openair-collective/openair-cyan/docs/Reference_Docs/extras/Cyan_Q_and_A.md

<h1>CYAN DECARBONIZER Q&A</h1>

<h2>General</h2>

<b>Q1. Where did Cyan come from and who invented it?</b>

A1. The Cyan idea was conceived by Dahl Winters of DeepScience Ltd in late November, 2020. She built and later open-sourced Cyan; it is now the first OSHWA-certified direct air carbon capture unit (https://certification.oshwa.org/us001095.html). 

<b>Q2. What community is contributing to the Cyan project and who can join it?</b>

A2. The OpenAir Collective is the headquarters of the Cyan project. Anyone is welcome to join OpenAir at https://openaircollective.cc/join-us-1 and contribute to the progress of Cyan.

<b>Q3. What is the ultimate goal of the Cyan project? E.g., is it to be an educational resource so people can make their own boxes?</b>

A3. The goal of Cyan is to introduce small-scale carbon removal devices so that people feel more comfortable with the idea of carbon removal and are more likely to support the production and use of larger units. 

<b>Q4. Is there an intention to sell Cyan kits, or maybe completed Cyan units for people that don’t have time to build their own?</b>

A4. We might sell kits and completed boxes in the future, especially if the complexity of these grows, but for now the intention is to have people build their own.

<b>Q5. Is there a goal of OpenAir that open-source businesses might arise using the Cyan (or Violet) technology?</b>

A5. OpenAir wants to promote the growth of carbon removal and direct air carbon capture, so to the extent that open-source businesses might arise, that would seem consistent with our goals. However, there is no current goal to commercialize the Cyan/Violet technology, we just want to get the technology out there for as many people to use and improve.

<h2>Technical</h2>

<b>Q6. What is the mechanism by which humidifying the air improves performance? Is it that the CO2 forms a carbonic acid mist, which reacts with the Ca(OH)2? Or another mechanism?</b>

A6. The mechanism is that there must be a thin layer of water on the surface of each grain of Ca(OH)2 for the CO2 to react with and form carbonic acid. The carbonic acid (H2CO3) can then react with Ca(OH)2 to form CaCO3 and H2O. This is an acid-base reaction and also a double displacement reaction. Humidifying the air increases the opportunity for this thin layer of water to form.

<b>Q7. Would moistening the Ca(OH)2 accomplish the same thing without having to humidify the air?</b>

A7. Moistening the Ca(OH)2 would certainly help the thin layer of water to form faster, but too much moisture impedes the airflow of CO2 between grains of Ca(OH)2. If all the pores are blocked with water, then we have the equivalent of an aqueous solution and CO2 is less soluble in water than in air.

<b>Q8. Are there any studies (theoretical or experimental) of the ideal humidity level?</b>

A8. There have been experimental studies of the ideal humidity level from concrete carbonation. Concrete contains calcium hydroxide and the ideal humidity has been between 50-75% (https://www.sciencedirect.com/science/article/pii/S1110016819301115). 

<b>Q9. What is the purpose in bubbling the air through the water in the bottom of the Cyan? If the air were humidified another way, would there still be any reason to bubble it? And in that case, would the water in the bottom of the box still be needed?</b>

A9. The air bubbling through water serves two purposes - to continuously add CO2 to the system for removal, and to get water onto the filter paper at a slow enough rate that the water is wicked across the filter paper and Ca(OH)2 powder to help form the necessary thin layer of water across each Ca(OH)2 grain. If the air were humidified another way, some mechanism would still be necessary to quickly wet the powder since air humidification is not fast enough (it takes concrete years for its calcium hydroxide to carbonate). The water at the bottom of the box is only there to wet the filter paper through bubbling.

<b>Q10. I saw a reference to an experiment using an ultrasonic humidifier; was that successful?</b>

A10. The ultrasonic humidifier was successful but it was not as energy efficient and required a longer time to thoroughly wet the material to near saturation. With larger quantities of material it might be useful, but for just 10 grams of Ca(OH)2 the emissions due to a power consumption of 24 W (24 V at 1 A) was more than the amount of carbon dioxide that would be removed.

<b>Q11. In the standard Cyan build, is there any significance to the dimensions of the specific hummus container used? Or to the exact depth of the water?</b>

A11. There is no significance to the dimensions of the hummus container used or to the exact depth of the water. The hummus container merely provides something for the filter paper containing the input material to rest on while it is being slowly wetted from below from the air bubbling and consequently the water being disturbed. If it is possible to wet the filter paper through a different means, as through an atomizer, there quite possibly would be no need for standing water at the bottom.

<b>Q12. Can the hummus container be replaced with anything (e.g. a wire shelf) that holds the Ca(OH)2 above the surface of the water?</b>

A12. Yes.

<b>Q13. What is the purpose of using a coffee filter instead of just scattering the material on the upturned lid?</b>

A13. The coffee filter is something that can be weighed beforehand and that also wicks water to slowly wet the Ca(OH)2 powder. Scattering the material on the upturned lid would not allow for easy removal (the powder sticks to the lid) and there is no easy way to slowly wet the powder.

<b>Q14. You mentioned that the aquarium pump can be shut off when the air is humid enough. In that case, how does more air get into the container?</b>

A14. The aquarium pump does not have to be run continuously; it can be shut off for intervals of time while the CO2 already in the container is taken up by the Ca(OH)2. The container is not air-tight so CO2 is always diffusing in and out. 

<b>Q15. Is the drying action of the fans an essential part of the carbon capture process, or is it a temporary R&D addition to the design to allow us to measure the effectiveness by weighing?</b>

A15. A significant amount of CO2 (as much as 50%) is taken up during the drying process and that CO2 uptake is aided by greater airflow. It improves the likelihood that a CO2 molecule will react with the wet Ca(OH)2. However, the fan is not deemed absolutely essential to the carbon capture process. CO2 will still be taken up, just at a slower rate.

<b>Q16. The current design captures about 2g of CO2 for each 10g of Ca(OH)2. How does this compare to the theoretical (stoichiometric) maximum amount that can be captured?</b>

A16. The theoretical maximum amount that can be captured is 5.94 g CO2/10 g Ca(OH)2 (and for Mg(OH)2, it is 7.55 g CO2/10 g Mg(OH)2). We are at best achieving about a third of the theoretical maximum. 

<b>Q17. If current performance is short of the theoretical, is that just because not enough surface area of the powder is exposed to the air?</b>

A17. There are a number of factors involved. Increases in temperature and pressure generally improve reaction rates. However, performance was increased by a factor of two just by manually disturbing the surface of the powder once, halfway during the experimental run. This leads us to believe that there is a surface area limitation. Mechanically disturbing the layer of powder in an intermittent manner should help greatly.

<b>Q18. Would efficiency be expected to improve if the air is made turbulent?</b>

A18. We believe we are not seeing laminar airflow in our system given the fluid properties and speeds of the air. The air is likely already turbulent, and especially so when the fan is being used for drying. If the air is made even more turbulent, efficiency could possibly improve, but this has not been tested.

<b>Q19. Has there been any confirmation of the accuracy of the weighing method for measuring captured CO2?</b>

A19. The weighing method is called gravimetric analysis and is widely used in chemistry for measuring the amount of a compound based on its mass. It suffers from the ability of product to be lost through container transfers and through evaporation. Of higher accuracy would be thermogravimetric analysis, but this is expensive and time consuming.

<b>Q20. What other materials besides Ca(OH)2 have been tried, and with what success?</b>

A20. Mg(OH)2 has been tried with similar and possibly slightly higher levels of carbon removal. It is also a more friendly material in terms of pH.

<b>Q21. Has anyone tried to calculate the carbon footprint of the whole device (plastic, etc.)?</b>

A21. Not completely, but it has been partially attempted. The carbon footprint of the energy consumption and the transportation of input material has been taken into account in the Cyan Supporting System Calculations.xlsx document available from our GitHub repository. In a separate document, estimates of the energy consumption used in producing Mg(OH)2 have also been done, namely to determine the degree of impact of various manufacturing processes on Cyan’s ability to achieve negative emissions. 

<b>Q22. Would it work to dissolve the X (OH) in solution, bubble the air through it, and let the X (CO3) precipitate out?</b>

A22. This would indeed work; aqueous solutions are used in industrial carbon removal (Carbon Engineering for example uses an aqueous solution of KOH). The difficulty here is in controlling leakage and evaporation effects and in filtering out the precipitate to weigh it and calculate the amount of CO2 captured. Inevitably, some precipitate sticks to the inner walls of the device, causing product losses prior to weighing.
