openair-collective/openair-cyan/docs/Reference_Docs/Aqueous-Cyan/Presentations/Aqueous CYAN Update  9-13-2021.pdf

# Aqueous CYAN Update

David Wilson
dw@ieee.org September 13, 2021

Topics:

•New pH probe!
•Aqueous run with pH and EC •Scaling up?

## Aqueous CYAN Basics

- Same reaction as Classic CYAN: Ca(OH)2 + CO2 → CaCO3 + H2O
- Parts reuse: Aquarium pump, air stone, chemicals, soda bottle
- Newer: Electrical Conductivity (EC) Monitoring
- Even newer: pH meter

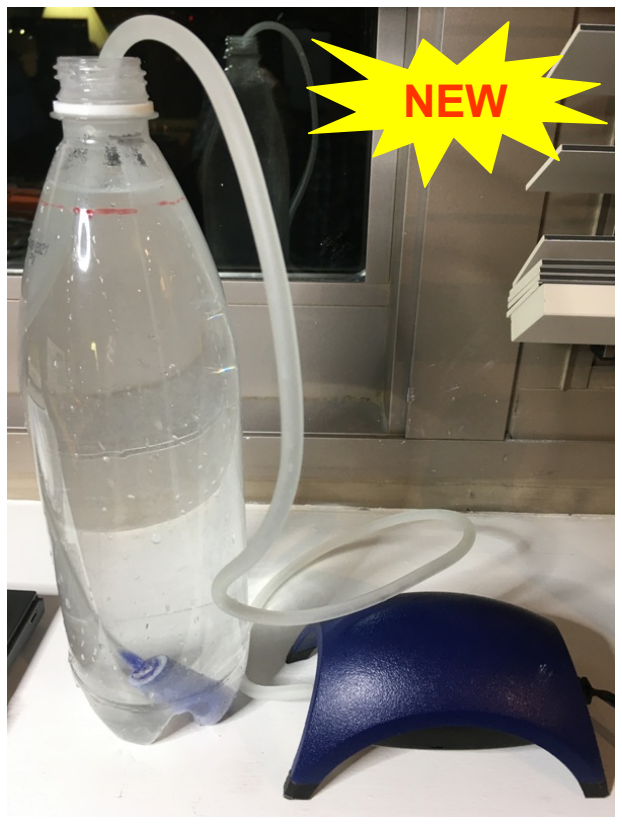
[picture p6: figure]
NEW

## EC Measurement

https://hackaday.io/project/7008-fly-wars-a-hackers-solution-to-world-hunger/log/24646-three-dollar-ec-ppm-meter-arduino

•Probe: 2 wires, 2 buttons
•Circuit: voltage divider and uC
•PULSED measurement required •OMIT temperature adjustment •Note: EC probe interferes with pH measurement, so had to isolate (not shown)

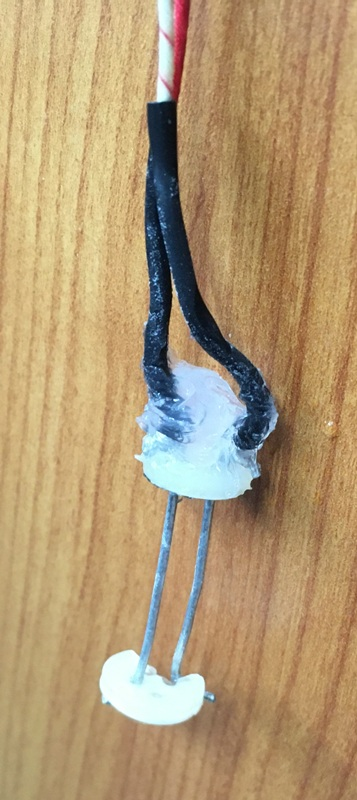
[picture p7: figure]
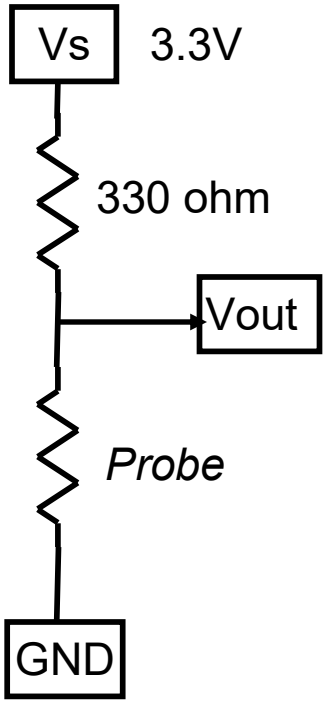
[picture p8: figure]
GND; Vout; 330 ohm; Probe

## Han’s Paper

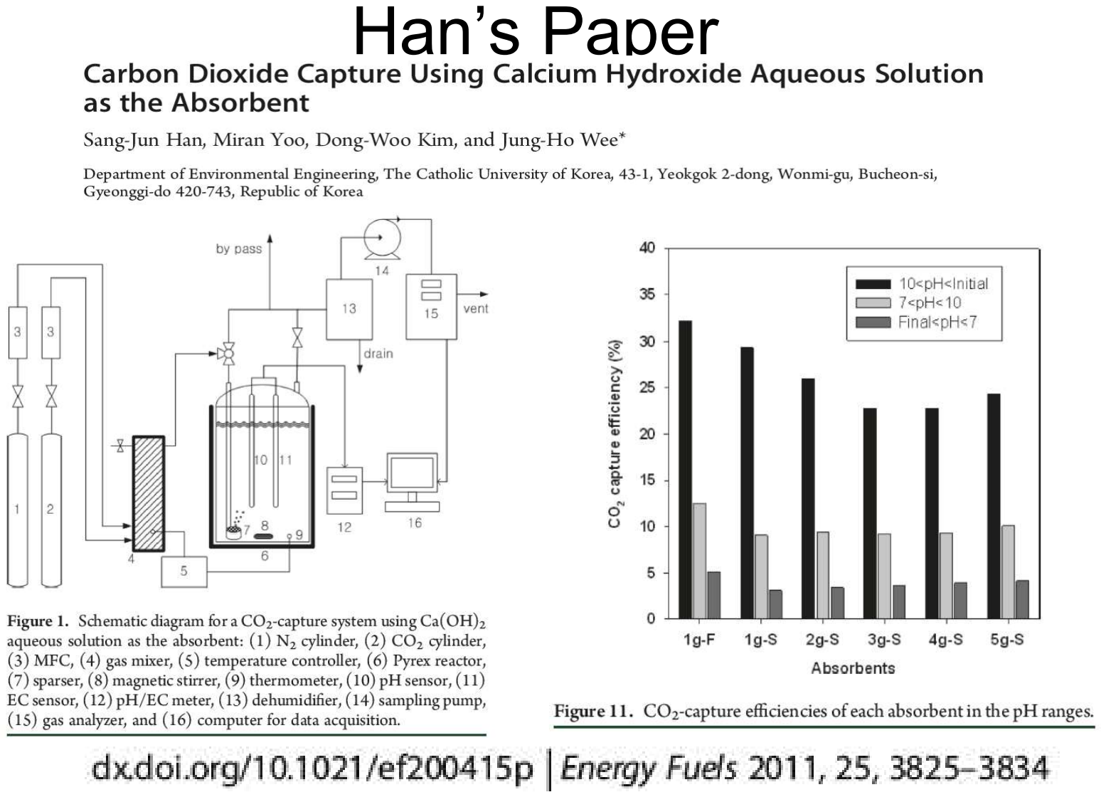
[picture p9: page 4]

## Han Paper Detail

Saturated Ca(OH)2 solution

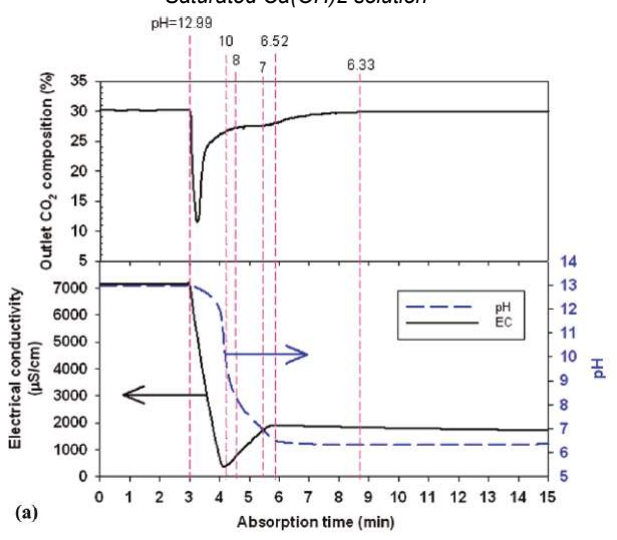
[picture p10: figure]

## Newest Experiment: Now with pH Meter

- 1g Ca(OH)2

in 1L water. Solubility of Ca(OH)2 in H2O:

### 1.73 g/L at 20C. [Same as last time]

- Calibration of EC probe: estimate 8000uS/cm (*) in our solution
- Pumped air through air stone (bubbler), while measuring EC every 30 seconds.
- Also measured pH (with meter).
- Kept going until EC and pH flattened out
- Used distilled water this time: no initial sediment

•Note on units: S ≡ Siemens ≡ mho ≡ 1/ohm
•It is /cm because it’s a spatially distributed resitance

# Results (1g/L)

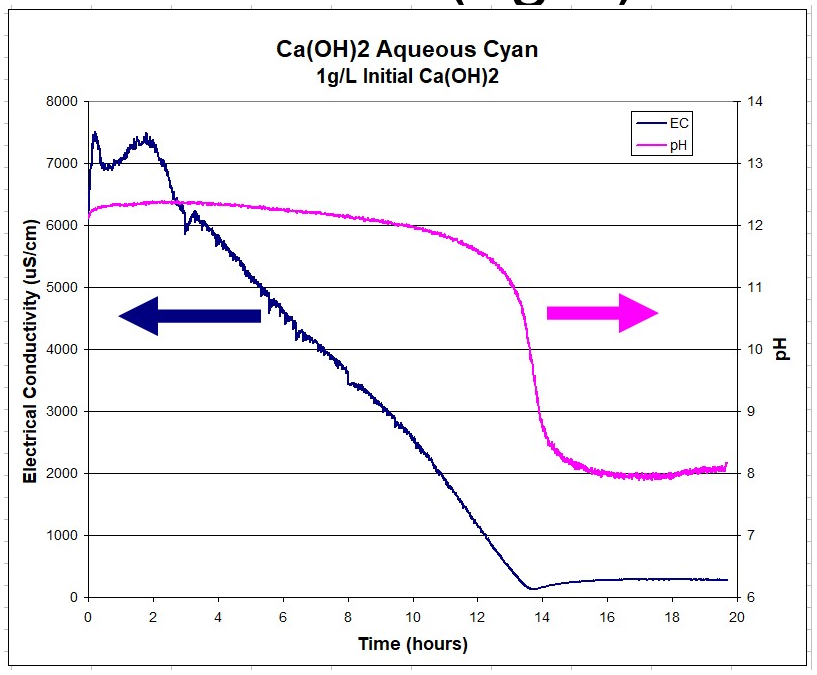
[picture p11: figure]

## What if we take log10 of EC?

(and shift to line up with pH)

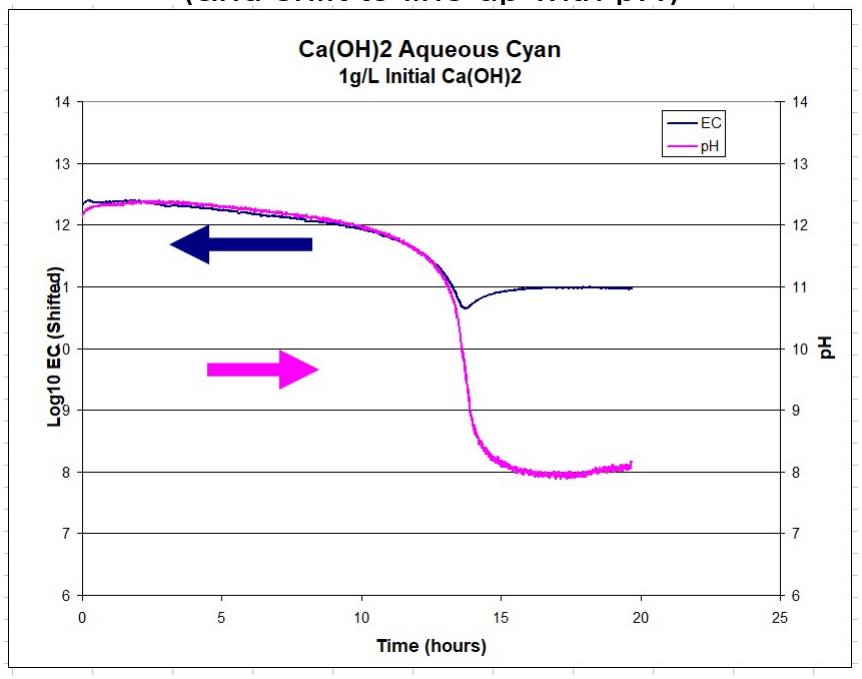
[picture p12: figure]

# Scaling up: 10g/L Aqueous Test

First run, uninterrupted

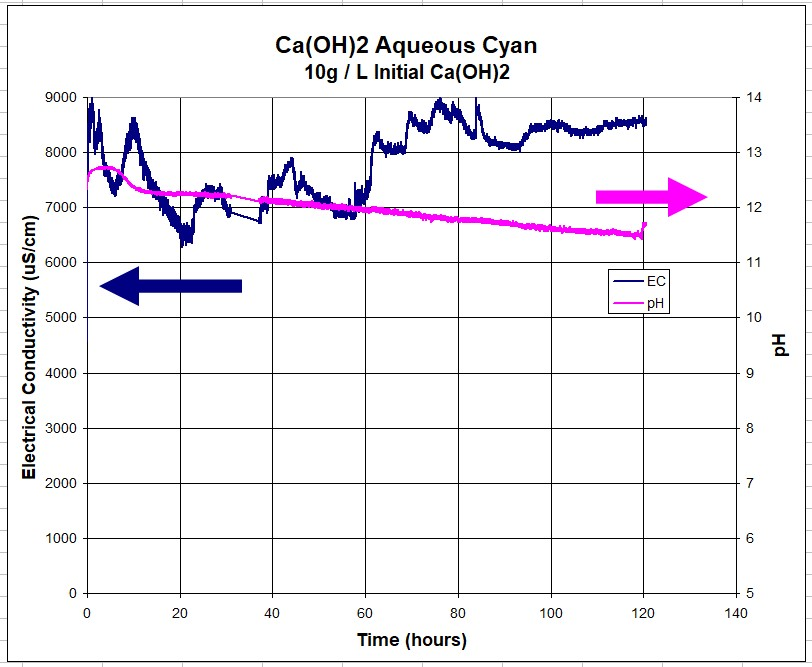
[picture p13: figure]

# Why?

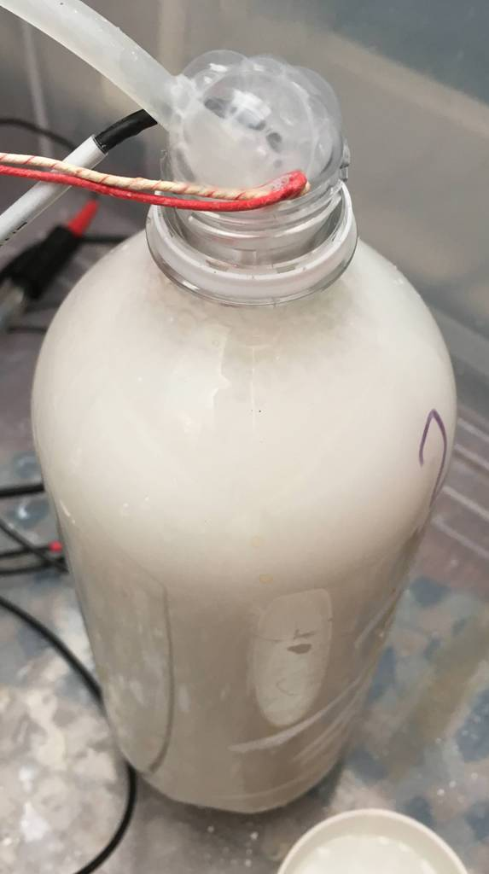
[picture p14: figure]

- Air stone getting clogged before run finishes
- Air stone not resting on bottom, so sediment+input
material not getting stirred up

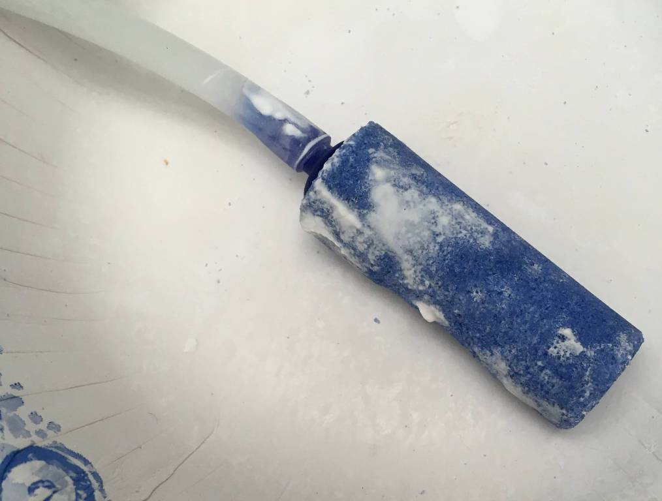
[picture p15: figure]

## Continuing Issue: Dirty Air Stone

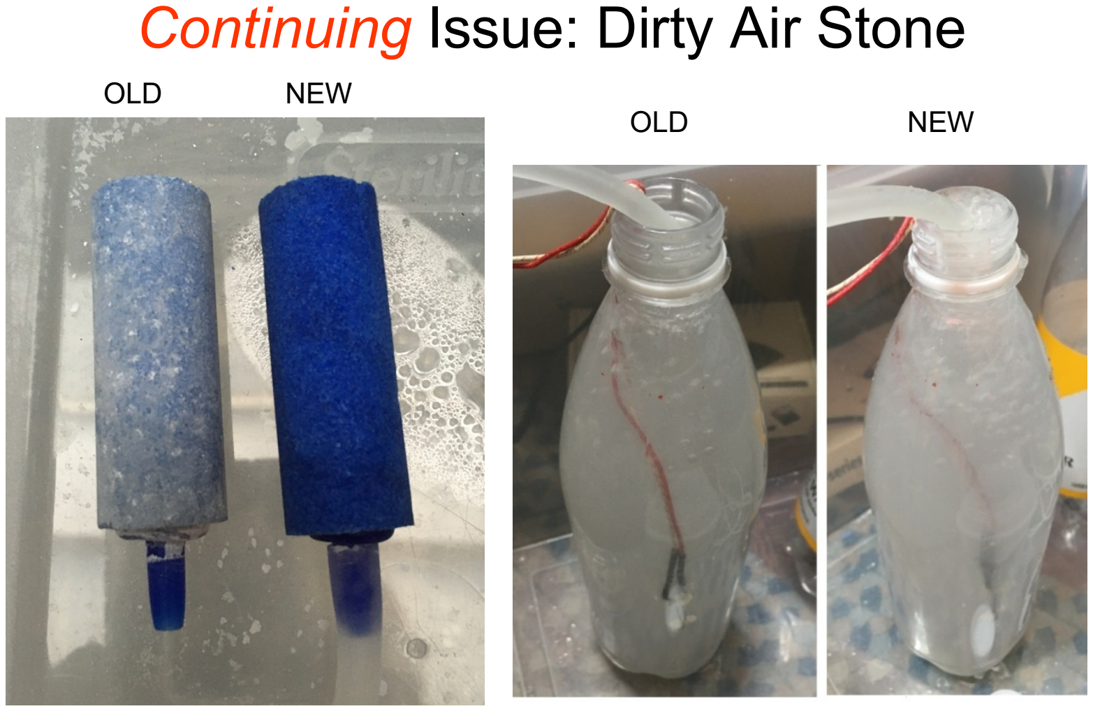
[picture p16: page 11]

OLD
OLD

NEW
NEW

# Attempted remedies

## - Clean air stone - Shake bottle thoroughly to stir up sediment - Make sure air stone rests on bottom of bottle to stir up sediment

## Scaling up: 10g/L Aqueous Test

CONTINUED after remedies

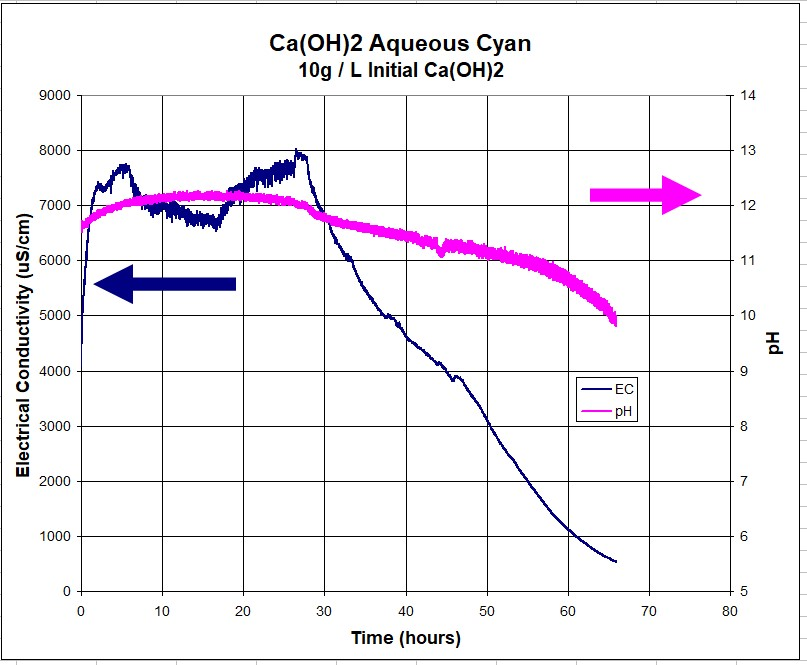
[picture p17: figure]

# After 10g run…

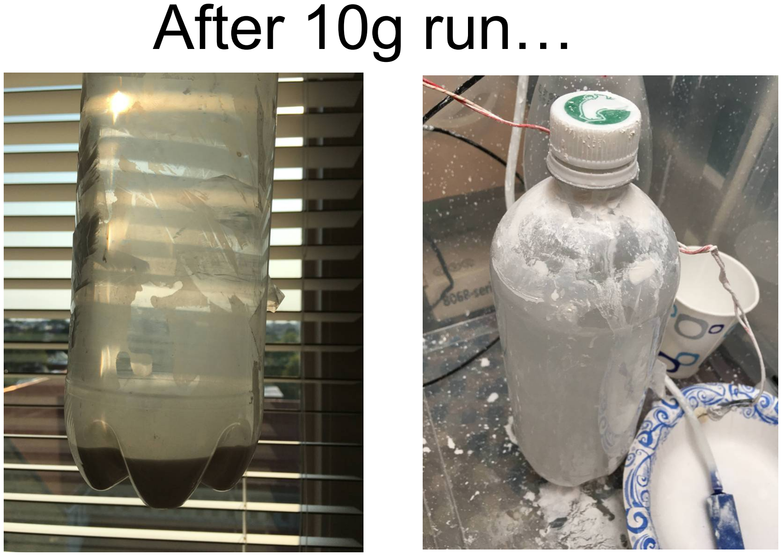
[picture p18: page 14]

## - Better aerator (sparger) needed? - Understand pH vs. EC - Need to pump more air - How to separate and dry precipitate? - Weigh precipitates from both runs and calculate amount of CO2 captured

# For Followup
