openair-collective/openair-cyan/docs/Reference_Docs/Aqueous-Cyan/Presentations/Aqueous CYAN Update  7-26-21.pdf

# Aqueous CYAN Update

David Wilson
dw@ieee.org July 26, 2021

## Aqueous CYAN Basics

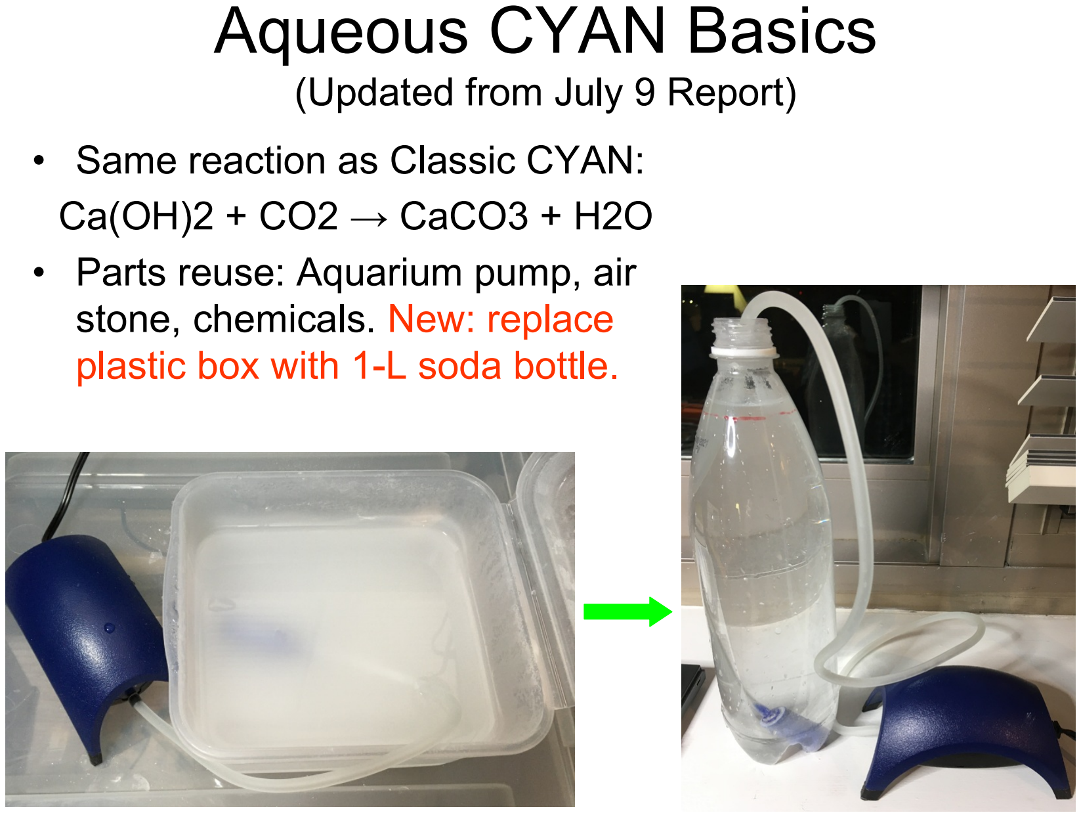
[picture p27: page 2]

(Updated from July 9 Report)
- Same reaction as Classic CYAN: Ca(OH)2 + CO2 → CaCO3 + H2O
- Parts reuse: Aquarium pump, air stone, chemicals. New: replace plastic box with 1-L soda bottle.

## Han’s Paper


## Main Take-aways (for me) from Han’s Paper

- When pH goes < 10 as CO2

is captured, CaCO3
(precipitate) production STOPS.
- As pH continues to drop, CaCO3 combines with more CO2

to produce (soluble!) HCO3

ions…
- …until by the time pH <7, there’s no more CaCO3 precipitate.
- We should stop when pH reaches 10, so we can recover solid output, and
- Most CO2 has already been captured.

## Han Paper Detail

Saturated Ca(OH)2 solution


# My Experiment

## - 1g Ca(OH)2

in 1L water. Solubility of Ca(OH)2 in
H2O: 1.73 g/L at 20C.
- Pumped air through air stone (bubbler), periodically checking pH with pH paper.
- Stopped when pH reached 10.

# pH vs. Time

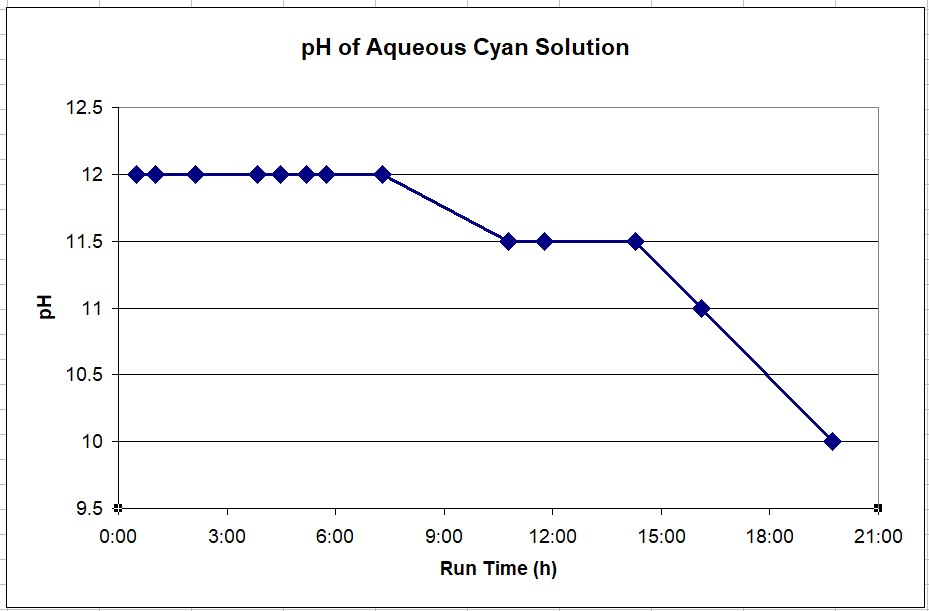
[picture p28: figure]

# Results

- Stopped at 19:44.

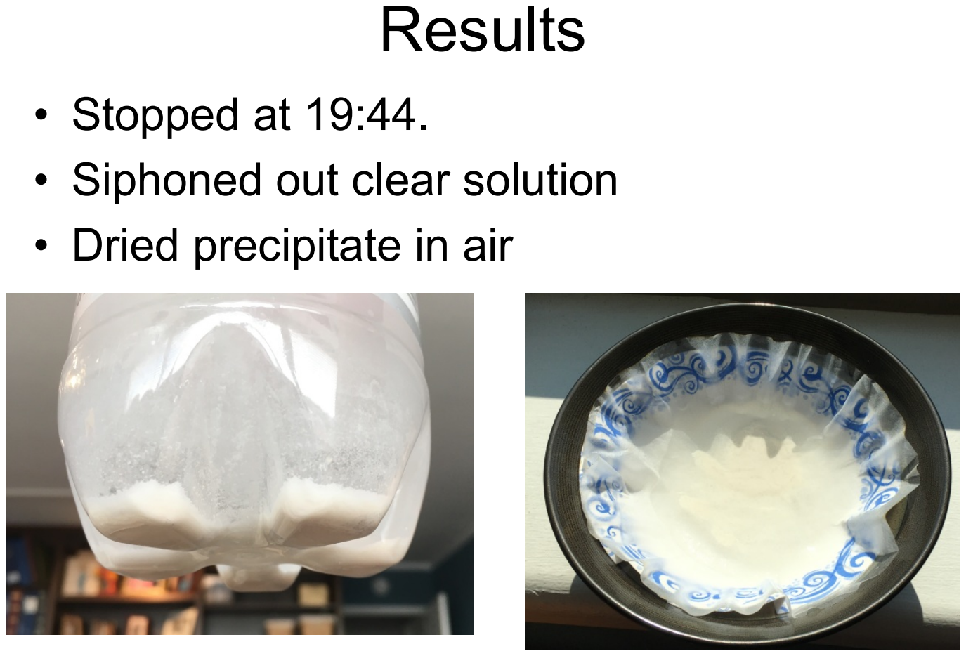
[picture p29: page 8]

## - Siphoned out clear solution - Dried precipitate in air

# Analysis

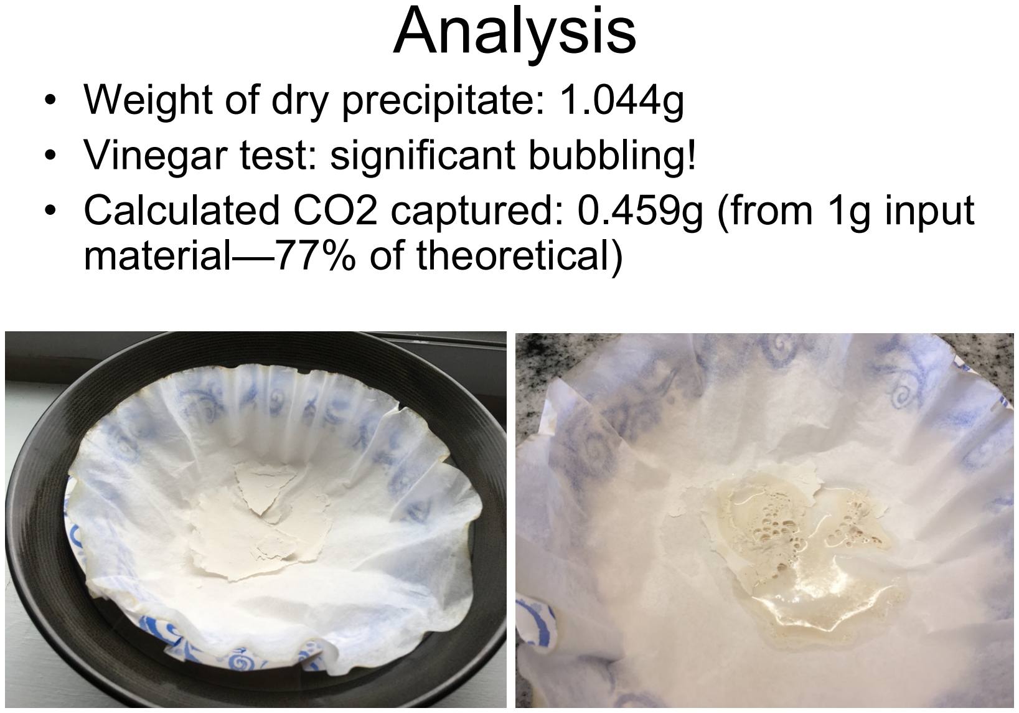
[picture p30: page 9]

- Weight of dry precipitate: 1.044g
- Vinegar test: significant bubbling!
- Calculated CO2 captured: 0.459g (from 1g input material—77% of theoretical)

## - Caveat: calculated capture amount may be over-estimate due to impurities in water

and sorbent.

## - Ideas for automating end of process:

– Electronic pH meter ($$)
– Electronic resistivity measurement ($)

## - Need to pump more air - How to separate and dry precipitate?

# Followup
