openair-collective/openair-cyan/docs/Reference_Docs/Aqueous-Cyan/Presentations/Aqueous CYAN Update  8-2-2021.pdf

# Aqueous CYAN Update

## David Wilson dw@ieee.org August 2, 2021

Topics:

•Dirty Air Stone
•Homemade EC probe
•Another Cyan run using EC probe

# Aqueous CYAN Basics

## (Updated from July 9 Report)

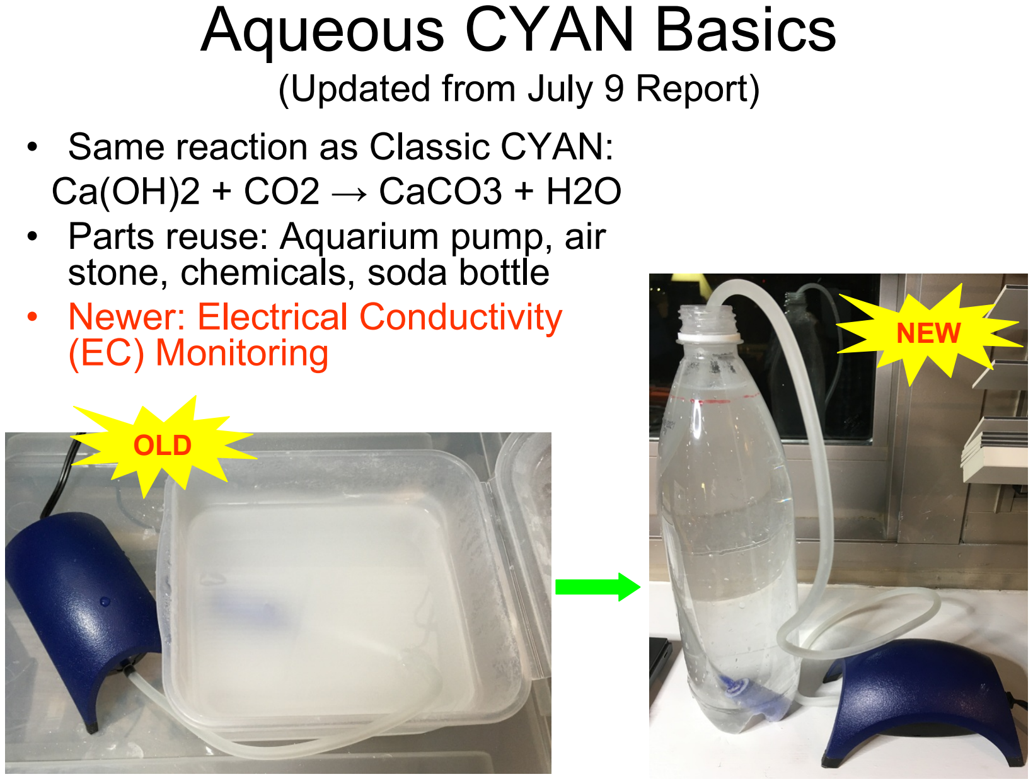
[picture p31: page 2]

## - Same reaction as Classic CYAN: Ca(OH)2 + CO2 → CaCO3 + H2O - Parts reuse: Aquarium pump, air stone, chemicals, soda bottle - Newer: Electrical Conductivity (EC) Monitoring

OLD

NEW

# New Issue: Dirty Air Stone

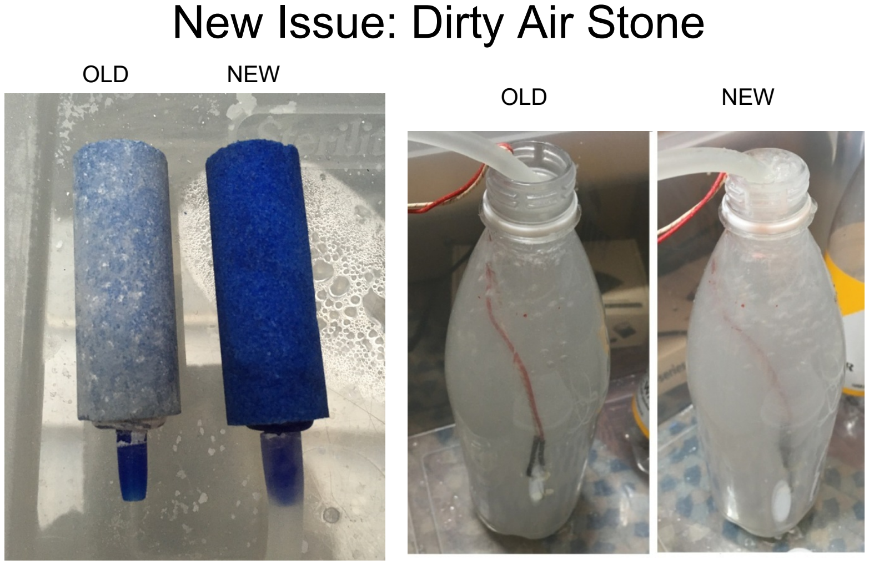
[picture p32: page 3]

OLD
OLD

NEW
NEW

# EC Measurement

https://hackaday.io/project/7008-fly-wars-a-hackers-solution-to-world-hunger/log/24646-three-dollarec-ppm-meter-arduino

GND; Vout; 330 ohm; Probe

•Probe: 2 wires, 2 buttons
•Circuit: voltage divider and uC
•PULSED measurement required •OMIT temperature adjustment

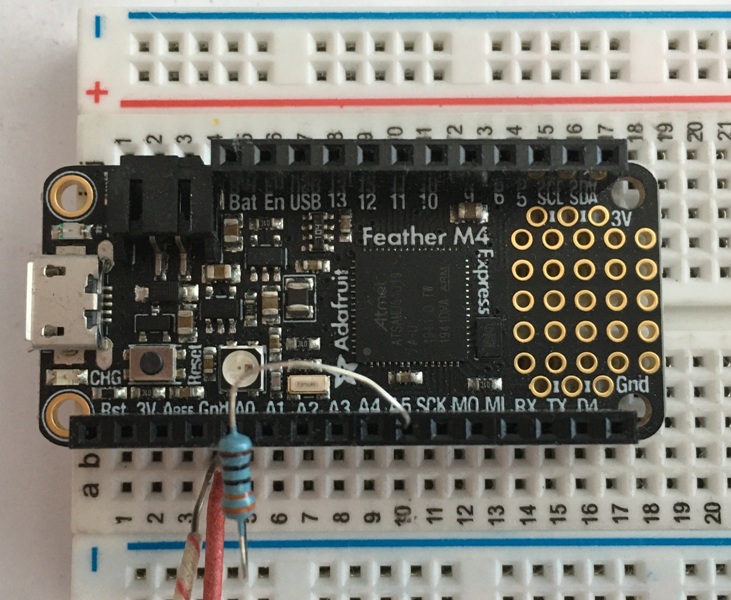
[picture p33: figure]

# Han’s Paper


# Han Paper Detail


Saturated Ca(OH)2 solution

# Newest Experiment

## - 1g Ca(OH)2

in 1L water. Solubility of Ca(OH)2 in H2O:

### 1.73 g/L at 20C. [Same as last week]

## - Calibration of EC probe: estimate 8000uS/cm (*) in our solution - Pumped air through air stone (bubbler), while

measuring EC every 30 seconds.
- Periodically measured pH (with paper).

## - Kept going until EC and pH flattened out

•Note on units: S ≡ Siemens ≡ mho ≡ 1/ohm
•It is /cm because it’s a spatially distributed resitance

# Results

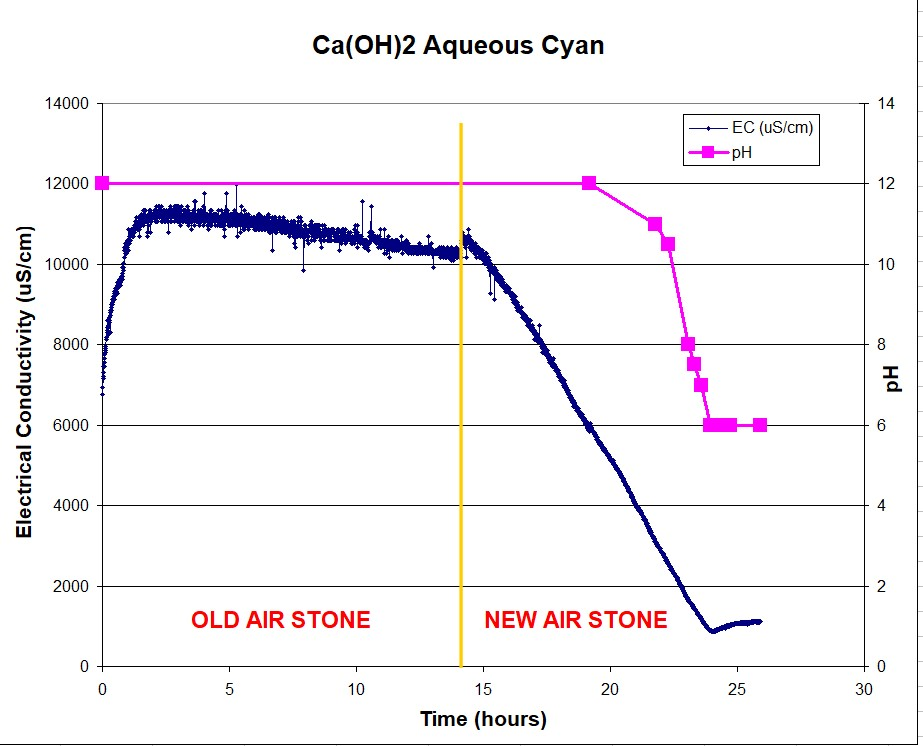
[picture p34: figure]

- Understand overshoot in EC at start.

# - Better air stone (sparger) needed? Or

keep, but clean or dispose.

# - Ideas for automating end of process:

## – Electronic pH meter ($$) – Electronic resistivity measurement ($)

# - Need to pump more air - Distilled water? Purer sorbent? - How to separate and dry precipitate?

# For Followup
