openair-collective/openair-cyan/repo-tools/CODE_OWNERS.md

# Code Owners

In addition to @dahlwinters the following code is mainly owned by:

| Code | Owner
|---|---
| CO2 Measurement |
| all | @DavidWilsonEE
| |
| Platformio Source Code |
| all | @ZanzyTHEbar
| |
| Documentation Webpage | @ZanzyTHEbar
