openair-collective/openair-cyan/docs/assets/images/vtEUvj4.jpeg

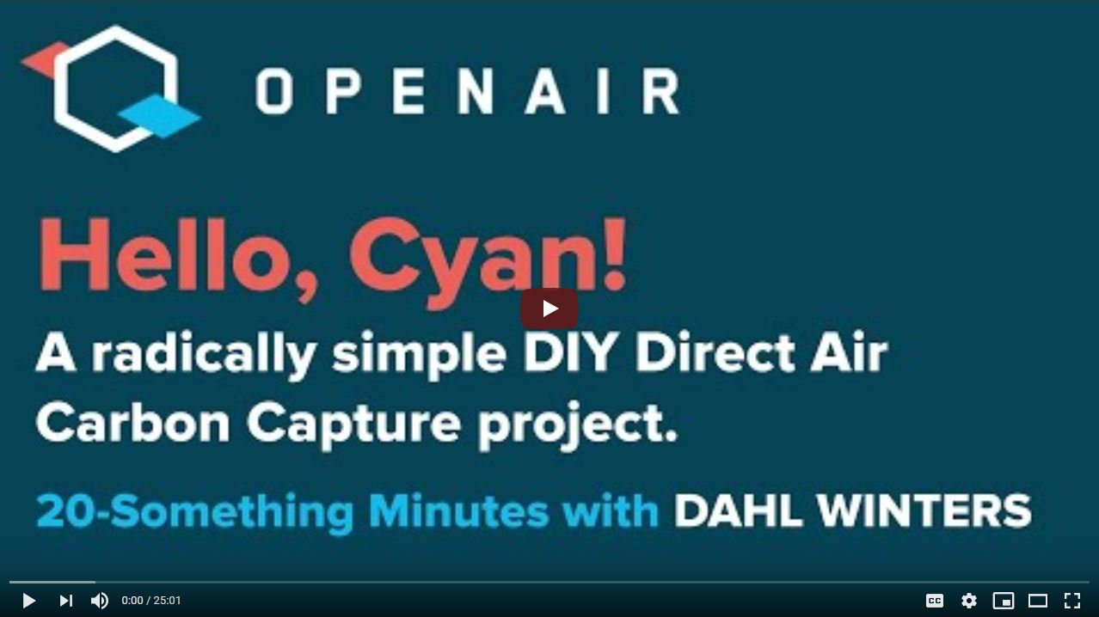
docs/assets/images/vtEUvj4.jpeg
