openair-collective/openair-cyan/docs/assets/images/assemblyinst/humidified_material.png

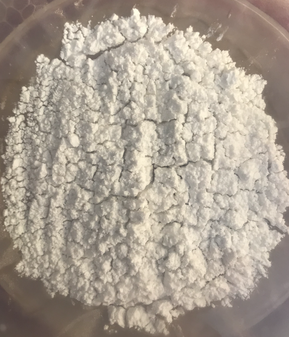
docs/assets/images/assemblyinst/humidified_material.png
