openair-collective/openair-cyan/docs/assets/images/assemblyinst/wet_filter_and_material.png

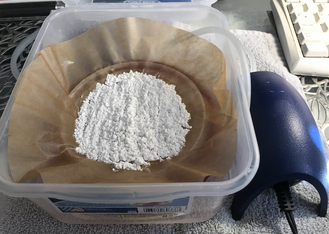
docs/assets/images/assemblyinst/wet_filter_and_material.png
