openair-collective/openair-cyan/Cyan_Assembly_Instructions.pdf

## Cyan: Open-Source Micro Direct Air Carbon Capture

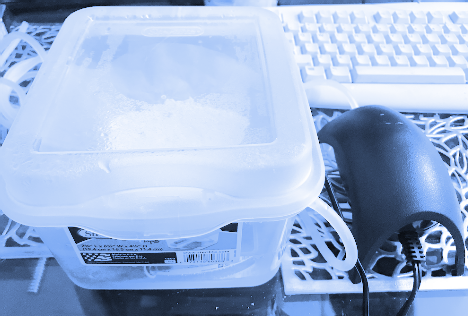
[picture p38: figure]

# Assembly Instructions

Dahl Winters, Member, OpenAir Collective

Purpose: These are instructions to build a DIY DACC unit for home or classroom use.

Expected results: an up to 12.5% weight increase from CO2 uptake over the course of a 16-hour period when starting with 10 g input material. This translates into about a 2.1 g CO2 uptake obtainable during a single run.

Minimal parts cost: <$20. All the bells and whistles mentioned: about $100.

A live version of this document can be found on our Cyan Google Drive at: https://drive.google.com/drive/folders/1jJmSW5A4CJa3AI3WlE5lJOv2GNdNztFd?usp=sharing 1

Table of Contents
Introduction | 3
CHEMISTRY AND BENEFITS | 3
CHALLENGES AND LIMITATIONS | 3
SAFETY CONSIDERATIONS | 4
Parts List | 5
Tools and Skills Needed | 9
Optional Materials for Testing | 9
Assembly Time Required | 9
Construction | 10
HUMIDIFIER BOX | 10
BOX AND FAN: AIRFLOW HANDLING | 12
Operation | 15
CALCULATING CO2 UPTAKE | 15
CONFIRMING THE PRESENCE OF CO2 | 16
STORAGE | 16
DISPOSAL/REUSE | 16
More Pictures | 17

2

Introduction

The goal of this project was to build a high-efficiency, very low cost direct air carbon capture (DACC) system. We call the system Cyan in honor of Violet, OpenAir’s moisture swing sorbent DACC, and also in honor of cyanobacteria, whose combined efforts transformed the early Earth’s atmosphere. Similarly, we believe millions of distributed, consumer-scale DACC units could someday complement large-scale DACC efforts and make a difference when it comes to climate change. This unit will not solve the climate crisis alone, but many of these will open doors to discussion, education, behavior changes, modifications, and further R&D to improve the state of DACC. And that is what we desperately need to limit the possibility of dangerous warming.

Chemistry and Benefits

The carbonation reaction (also known as carbonatation) is being used to capture CO2 as follows:

Ca(OH)2 + CO2

-> CaCO3 + H2O

This reaction takes place naturally, especially in concrete, but typically takes a very long amount of time (months to years). Cyan speeds up the reaction considerably by increasing the relative humidity and forcing this “wet” air into the reaction chamber to offset CO2 declines as the reaction progresses.

Calcium carbonate (CaCO3

) is a safe output that is actually the main constituent of limestone. It can be extracted, filtered, dried, weighed, and the quantity of CO2

taken up can be determined through calculation from the weight. No equipment is required to pressurize the captured CO2

, making
Cyan a good choice for true consumer-scale DACC.

Challenges and Limitations

The carbonation reaction is slow due to the formation of a passivating layer of CaCO3 around Ca(OH)2 molecules. While bubbles of CO2 were produced upon filtering, drying, and applying 5% distilled white vinegar (acid test for the presence of CaCO3

), it is very likely that not all the Ca(OH)2 is converted to CaCO3

in 24 hours. Thus we still need to quantify the amount of CO2

that is
captured per gram of Ca(OH)2

to see how that depends on different variables.

To achieve true negative emissions using Cyan, you will need to start with a source of carbon-neutral Ca(OH)2

. Hydrated lime is a good consumer source; it is very easy to buy hydrated lime at a gardening or hardware store. However, this hydrated lime comes from calcium oxide (lime) produced through calcination, a very energy-intensive process with temperatures above 900 degrees Celsius. This energy is typically supplied mostly by fossil fuels, though renewable sources are becoming increasingly prevalent in the energy mix. There are projects underway to produce 3 lime through concentrated solar, but for now this is a one-way reaction to produce calcium carbonate without regenerating the lime.

Safety Considerations

Ca(OH)2 comes in powdered form and although it has uses in pickling and gardening, it can do great damage if rubbed into the eyes, inhaled, or ingested. Scoop the material and avoid pouring; if you do pour, a mask should be worn so as not to inhale the dust.

Do not ingest any reactant or product, even the calcium carbonate you produce. It’s never a good idea to eat the products of your chemical reactions.

Also, since the aquarium air pump does not have a grounding plug (the case for most such pumps), the safety considerations for working with electricity near water should be observed.

4

Parts List

The following 5 items are the minimum required parts to construct a Cyan. Total cost <$20.

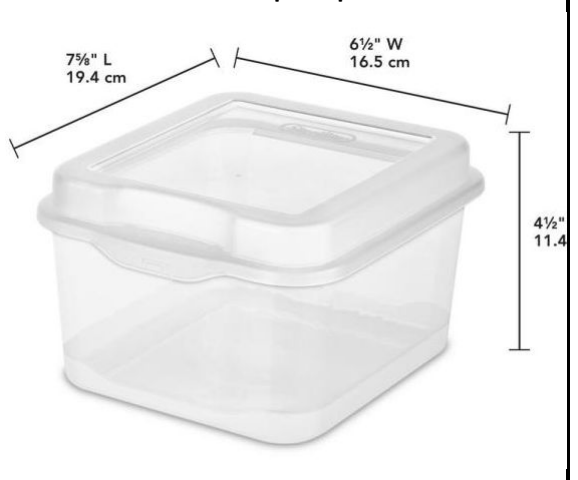
[picture p39: figure]
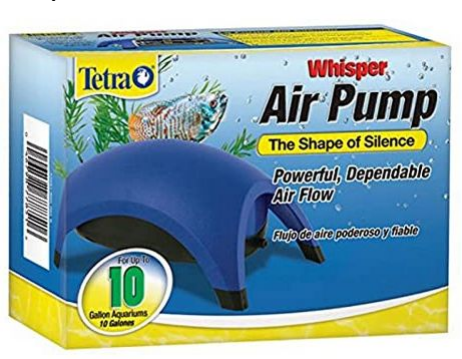
[picture p40: figure]
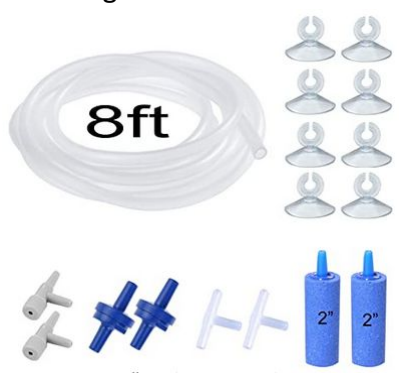
[picture p41: figure]

1
https://www.homedepot.com/p/Sterilite-2-5-Qt-Flip-Top-Box-18038612/203002006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 (https://www.homedepot.com/p/Sterilite-2-5-Qt-Flip-Top-Box-18038612/203002006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)
2 https://www.amazon.com/Tetra-Whisper-Easy-Aquariums-Non-UL/dp/B0009YJ4N6
3 https://www.amazon.com/gp/product/B0797QFV4D
5
Item | Use | Qty | Price | Qty for price

Per unit
price

Units
used

Subtotal

Sterilite 2.5 Qt FlipTop 1 | Outer container (“humidifier box”), dimensions are 7 5/8" x 6 1/2" x 4 1/2" | 1 | $2.28 | 1 | $2.28 | 1 | $2.28
Tetra Whisper 10 Aquarium Air 2 Pump | For airflow to let in CO2 ; needs AC outlet, 1.5 watts only | 1 | $5.06 | 1 | $5.06 | 1 | $5.06
3 Air Tubing and Air Stone | To disperse the air from the air pump, 3/16” diameter | 1 | $4.99 | 2 | $2.50 | 1 | $2.50

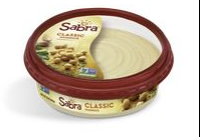
[picture p42: figure]
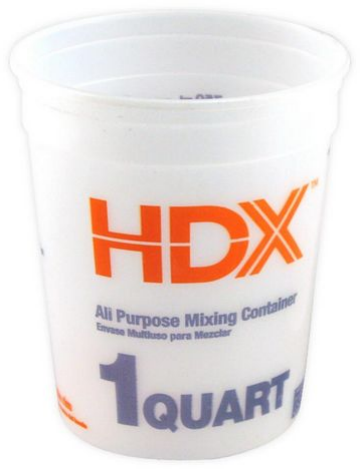
[picture p43: figure]

4 https://www.walmart.com/ip/Sabra-Roasted-Red-Pepper-Hummus-10-oz/10850131 5 https://www.homedepot.com/p/HDX-1-qt-Multi-Mix-Pail-2M3/202264024
6
Empty Sabra Hummus Container, 4 10 oz | Used for spacing; coffee filter goes on the HDX Quart lid that floats on top of this container. Could potentially remove or size down to add more space for Ca(OH)2 . | 1 | $3.34 | 1 | $3.34 | 1 | $3.34
Lid from HDX Quart Container 5 | Has a lid that the coffee filter holding the Ca(OH)2 sits in so as not to get too wet. Also comes graduated with lines, useful for measuring and mixing materials. | 1 | $1.38 | 1 | $1.38 | 1 | $1.38
total | $17.05

Below are optional items - you may choose to put the above setup within the file box below for easy portability and to expand the amount of space available for carbon capture. Mounting the fan on the box will also allow you to dry your CaCO3

faster once you are done humidifying it, though the fan also uses about 3 more watts of electricity. The fan may contribute to extra CO2 uptake during the drying time.

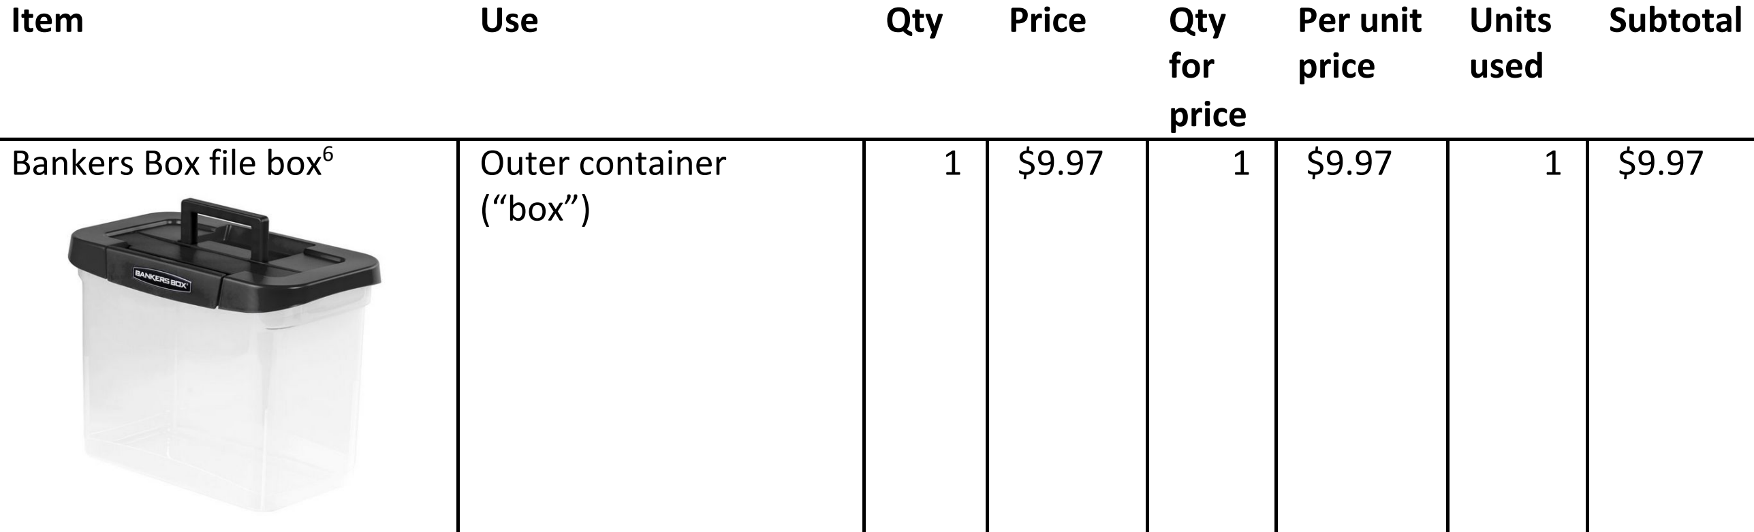
[picture p44: figure]
Item; Use; Qty; Price; for price; Per unit price; Units used; Subtotal; Bankers Box file box 6; Outer container (“box”)

6 https://www.walmart.com/ip/Bankers-Box-Plastic-Portable-File-Box/155376229
7 https://www.amazon.com/gp/product/B00G05A2MU/ref=ppx_yo_dt_b_asin_title_o02_s02?ie=UTF8&psc=1 8 https://www.amazon.com/dp/B08FY7QQ6L?psc=1&ref=ppx_pop_dt_b_product_details
9 https://www.amazon.com/gp/product/B08CC6SYCH/ref=ppx_yo_dt_b_asin_title_o02_s02?ie=UTF8&psc=1
7
120 mm computer fan, AC Infinity Multifan S3 7 | Airflow, USB-powered, 3 speeds | 1 | $11.99 | 1 | $11.99 | 1 | $11.99
120 mm safety grilles 8 | Comes in packs of 4 for screening air | 3 | $6.99 | 4 | $1.75 | 3 | $5.24
USB and AC power adapter 9 | for everything to plug into | 1 | $14.99 | 1 | $14.99 | 1 | $14.99
total | $43.94

If you don’t already have a scale to weigh your Ca(OH)2

, this is a good one, along with a source of Ca(OH)2

to get you started and some coffee filters for holding your samples:

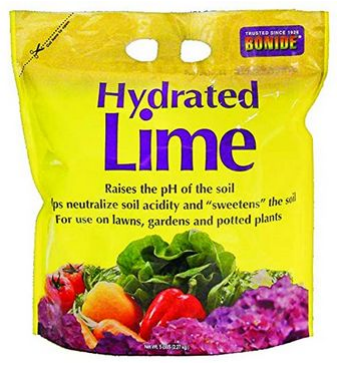
[picture p45: figure]
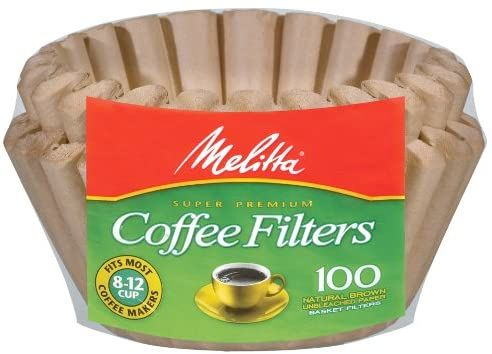
[picture p46: figure]

10 https://www.amazon.com/Triton-Digital-Pocket-Formula-Jewelry/dp/B00AE0GVYK
11 https://www.amazon.com/Bonide-Chemical-Number-5-Hydrated-Lime/dp/B00BSH0U4A 12 https://www.amazon.com/Melitta-Basket-Filters-Natural-Unbleached/dp/B00027930Y
8
Item | Use | Qty | Price | Qty for price

Per unit
price

Units
used

Subtotal

Triton T2 scale 10 | Weighing Ca(OH)2 | 1 | $18.95 | 1 | $18.95 | 1 | $18.95
Bonide Hydrated Lime, 5 11 lb | Main input; for capturing CO2 . Can also try hydrated lime from a hardware store in the cement aisle; there they have 50 lb bags for the same price as this 5 lb bag. . | 1 | $17.02 | 1 | $17.02 | 1 | $17.02
12 Coffee filters, 8-12 cup | Holding the Ca(OH)2 -you can weigh the filter beforehand, write the weight on the filter, then add your Ca(OH)2 , run, dry, weigh, then subtract the filter weight to get your product weight. | 1 | $7.99 | 100 | $0.08 | 100 | $7.99
total | $43.96

Tools and Skills Needed

- Drill with 8/32” drill bit (for fan mounting holes)
- Scissors (useful for cutting tubing)
- Box cutter (for scoring and cutting the fan ventilation holes)
- Sharpie or other permanent marker (optional but very useful)
- Small reciprocating saw (optional - would be useful for cutting the round ventilation holes on the sides of the file box)

Optional Materials for Testing

- 5% distilled white vinegar (for testing for CaCO3

)

- Spoon (for dispensing Ca(OH)2 without the need to pour it)

Assembly Time Required

Minimal unit assembly takes a few minutes, assuming you’ve already eaten the hummus from the hummus container. The file box + fan assembly can be done in 2 hours following the provided instructions.

9

Construction

Humidifier Box

Wash the Sabra hummus container (“container”) thoroughly. Create a hole in the center of the lid since you will be letting in water, otherwise the container will float within the box. You may wish to remove a few labels before placing the lid on top and placing the whole assembly within the Sterilite FlipTop box.

Cut about 1 foot of air tubing (this may be too
short for your needs, but ideal if you are locating
the pump directly alongside the box). Attach the tubing to the pump, then attach the air stone to the other end of the tubing. The air stone is the blue porous ceramic object; air blows into the stone and finely diffuses through to create many small bubbles.

Place the container inside the box. It should fit very nicely and effectively divide the space
between the upper and lower halves of the box.

Fill the box up to the level of the container lid

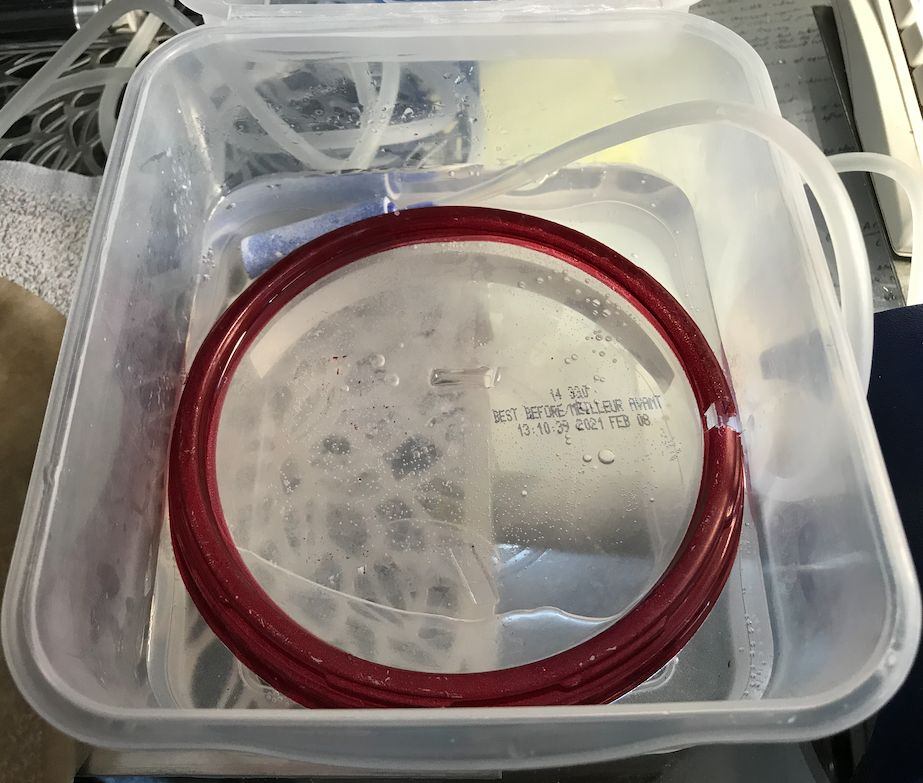
[picture p47: figure]

with water. Allow the water to go into the container as well. The water level should be up to the top of the lid (the whole container should be submerged).

Place the air stone so that it is on its side, alongside the submerged container. One of the back corners near the box’s hinge is a good place. You may wish to drill a hole in the lid to allow the air tubing to easily pass through. We did not find a hole necessary, as the lid can be snapped mostly shut with the air tubing in place.

10

Place the HDX quart container lid on top of the hummus container lid. It will float in place and should not sink. This is shown at right.

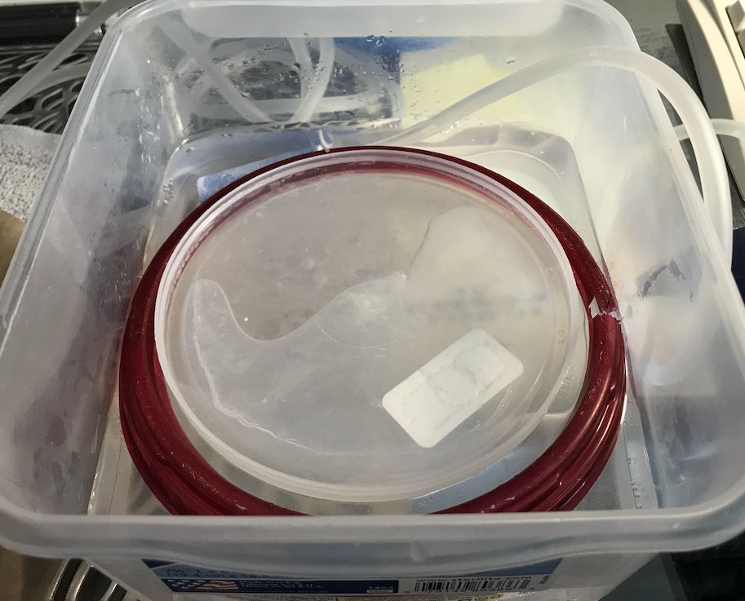
[picture p48: figure]
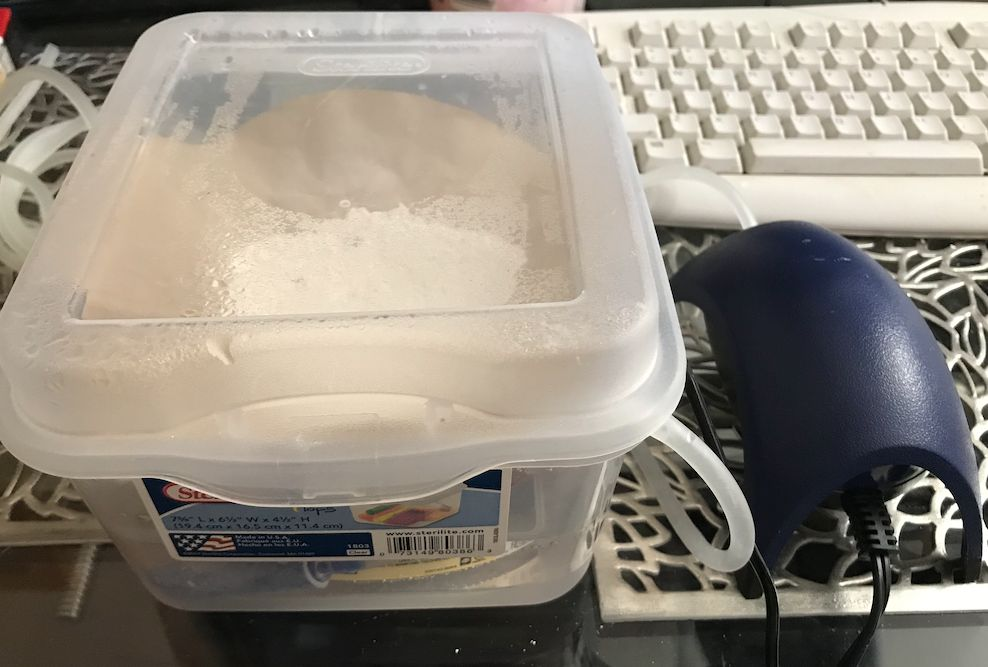
[picture p49: figure]

When ready to do a run, you will add a coffee filter with the desired amount of Ca(OH)2 onto the HDX lid, close the box lid, then plug in the air pump and let it run for your desired amount of time (upper left).

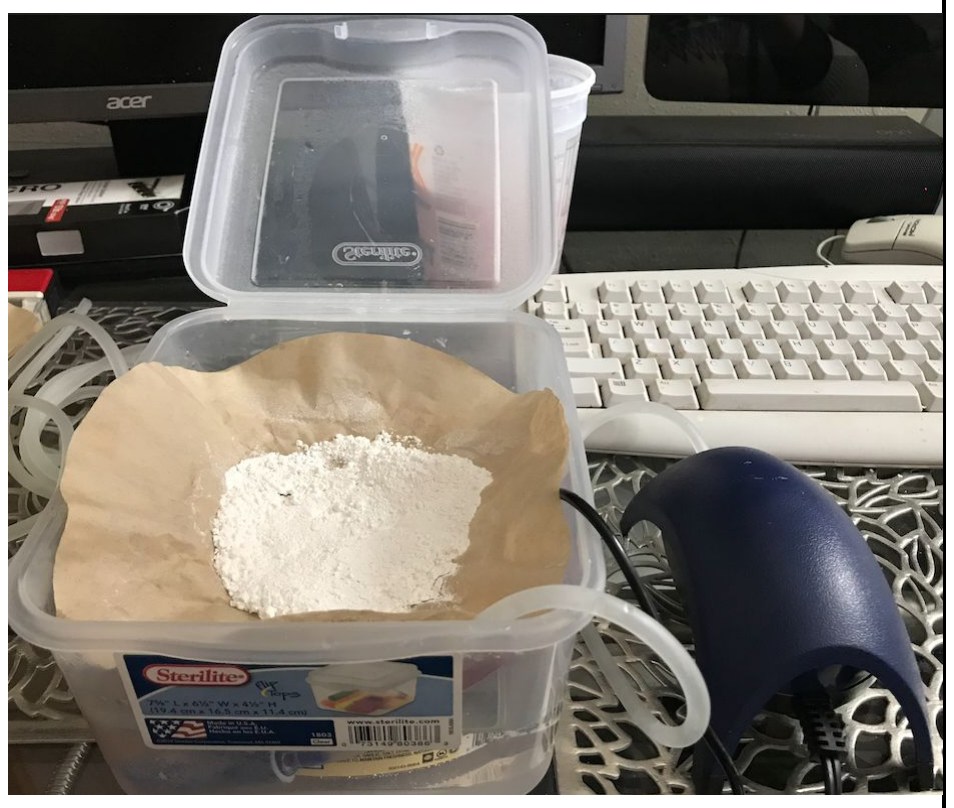
[picture p50: figure]
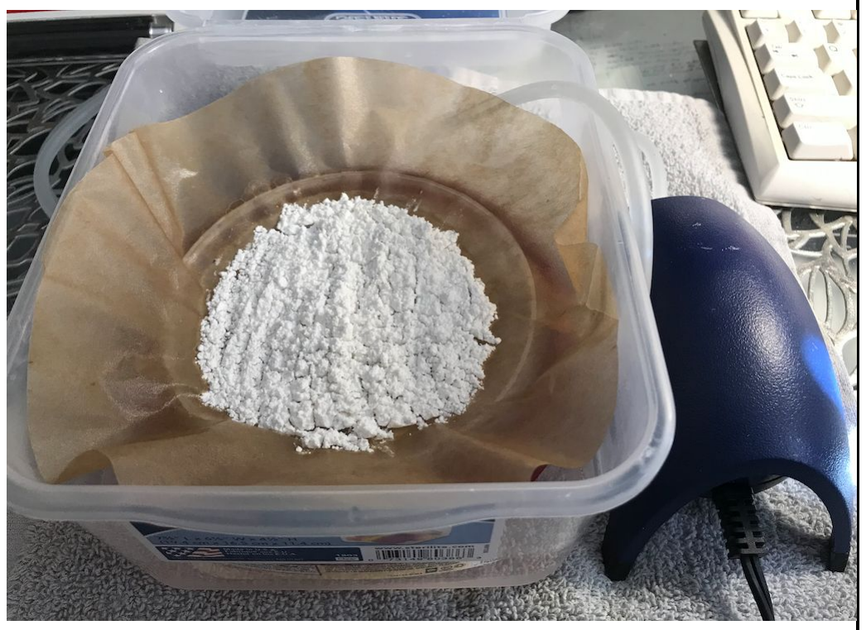
[picture p51: figure]

If you wish to speed up the drying process after you remove the coffee filter (i.e. to weigh the product and find out how much CO2 you obtained), please go on to the next section which is the box and fan assembly.

11

Dry Filter and Powder (initial loading) | Wet Filter and Powder (after 12 hours)

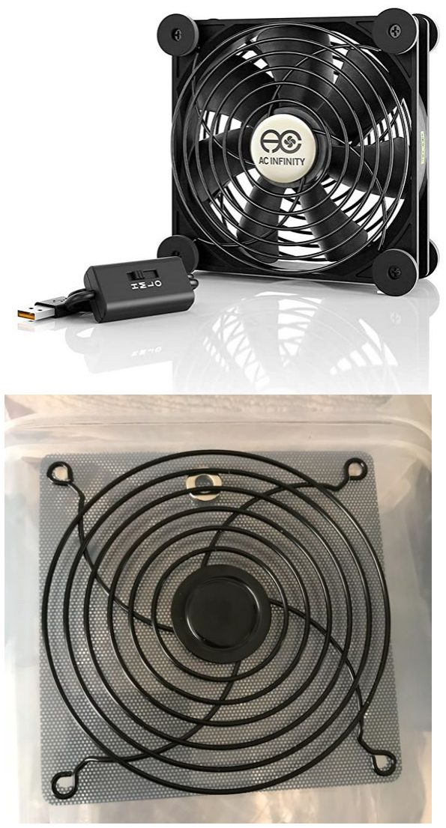
[picture p52: figure]

Box and Fan: AIrflow Handling

The fan has two sides, each with four corners with anti-vibration foam pieces held in place by screws. The fan grilles are also held in place with these screws. The fan will blow air in the direction of back to front, so when we mount the fan on the side of the box, we expect it to pull air from inside and push it outside.

We will use one of the fan grilles as a template for where to drill holes into the side of the box, as well as where to cut the circular hole that will let the air through.

Disassemble the back of the fan to obtain just the grille by unscrewing the 4 screws at each corner. You will not need the anti-vibration foam piece at each corner for anything so those can be saved for other uses.

Once you have the back grille off, center it on the short side of the box, just under the plastic handle. You can use optional neodymium magnets to hold the grille in place by putting one magnet on the outside and one on the inside of the plastic side wall.

12

Next, score the plastic along the outermost circle on the grille with a box cutter blade. You may also decide to use a Sharpie to more clearly identify the hole to be cut. Instead of a box cutter blade, a small tooth reciprocating saw would be very helpful to avoid the initial breaks in the plastic caused by getting the hole started and widened.

Once the hole is cut, on the inside, take the 4 screws and back grille from the fan and slip one of the safety grilles between the back grille and the fan blade. A safety grille should also be added between the front grille and fan blade as well. One is not shown in the image below and to the right
for initial airflow considerations, but it is advisable
if you might have small external objects that could

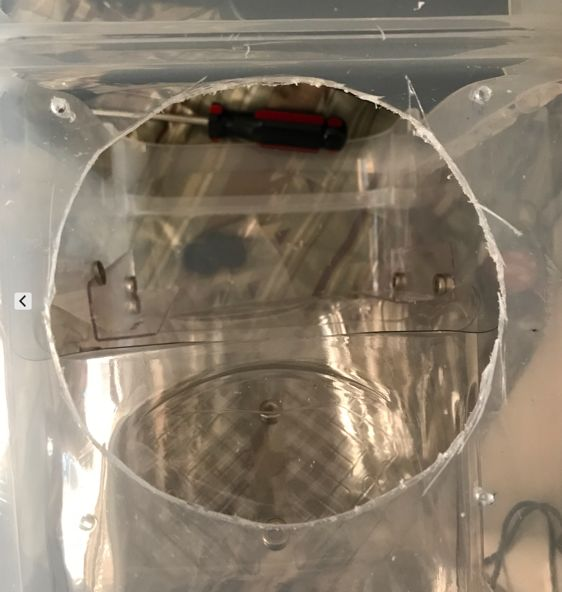
[picture p53: figure]

find their way through the front grille and into the fan blade.

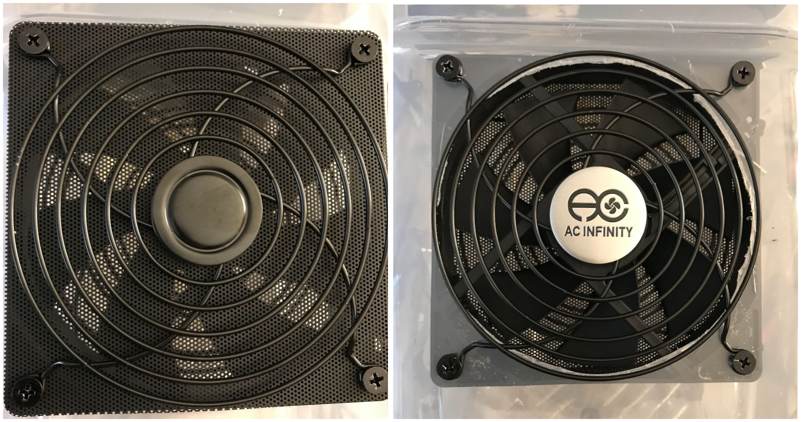
[picture p54: figure]

Back | Front

13

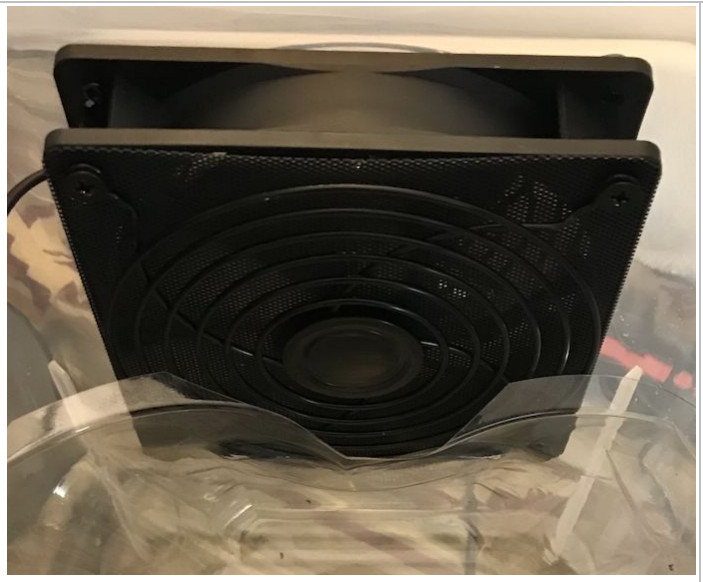
[picture p55: figure]
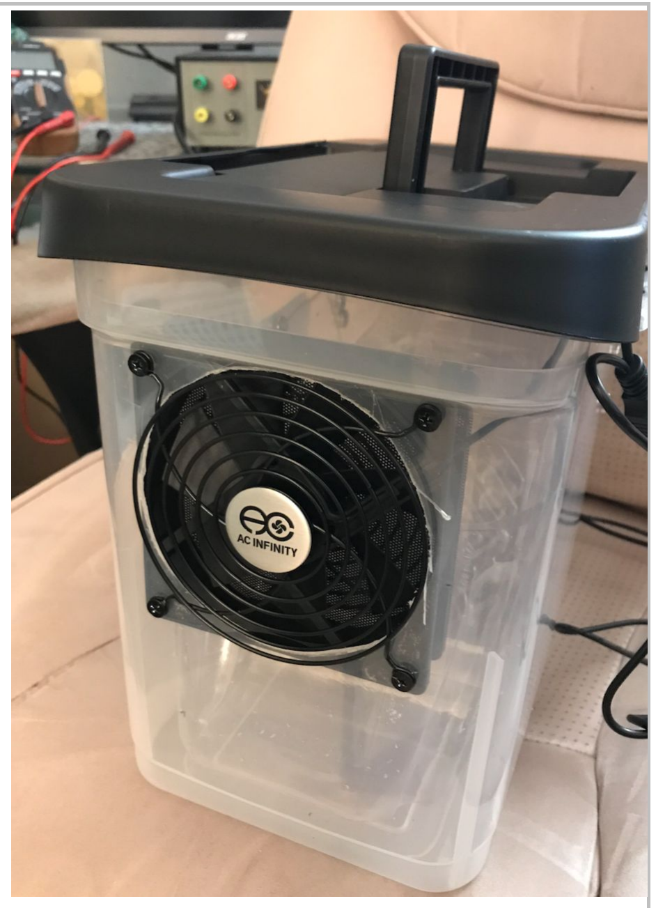
[picture p56: figure]

For the input vent, repeat the hole-cutting process on the opposite side of the box from the fan, using the 8/32” screws and nuts provided with the safety grilles to add two safety grilles, one on the inside and one on the outside. The screws should face inward for best appearance.

14

View of the mounted fan from the inside, looking outward. Plastic at bottom is part of the front paint liner that will hold the aquarium pump.

The mounted fan on the side of the box.

Operation

Measure out a desired quantity of Ca(OH)2

for your
test and add it to a coffee filter that has already been weighed without Ca(OH)2 added to it. Place the coffee filter onto the HDX lid that is within the humidifier box. Close the lid and run the air pump for your desired amount of time. The powder will start to clump up and form cracks as humidification takes place.

Calculating CO2Uptake

The coffee filter plus product should be thoroughly dried before weighing. Subtract the weight of the coffee filter and also the weight of the Ca(OH)2

that
you added. That will give the amount of mass change
that has taken place. This change in mass is equal to

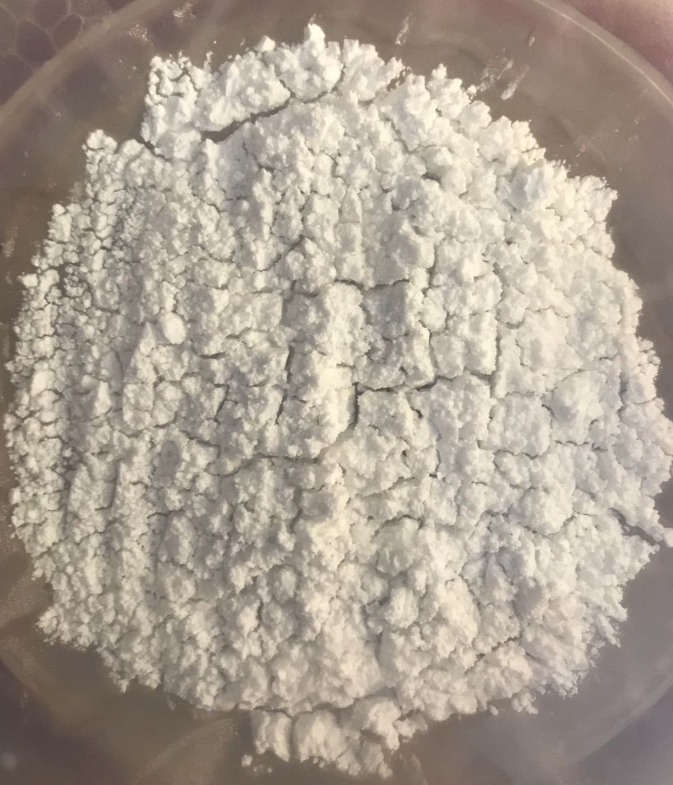
[picture p57: figure]

the grams of CO2 sequestered minus the grams of water that have evaporated.

The carbonation reaction once again is Ca(OH)2 + CO2

-> CaCO3 + H2O. Since both sides of the equation must have the same mass (mass balance), the following must also be true:

change in mass = x * (mol wt CaCO3

- mol wt Ca(OH)2

)
= x * (100.0869 g/mol - 74.09268 g/mol) = x * 25.9942

where x = moles of CaCO3 produced.

It also follows that the grams of CO2 captured is x * (mol wt CO2

), which equals x * 44.0095 g/mol.

Thus the change in mass that is measured must be scaled by a factor of (44.0095/25.9942) = 1.693 to obtain the actual amount of CO2

taken up.

Example: You have added 10.00 g Ca(OH)2
to a coffee filter weighing 0.86 g. The total initial weight is 10.86 g.

15

After your run, you measure a weight of coffee filter + product of 12.11 g.

You subtract the weight of the coffee filter to get the weight of the product, which is 12.11 g - 0.86 g = 11.25 g.

The mass change from final to initial time points is thus 11.25 g - 10.00 g = 1.25 g.

You must then increase the mass change by a factor of 1.693 to get the weight of CO2

taken up.
This is 1.25 g * 1.693 = 2.12 g.

The above was taken from the best experimental run so far. For approximately every 5x Ca(OH)2 inputted, 1x CO2

is taken up. Making a thin layer of Ca(OH)2

really seems to help.

Confirming the Presence of CO2

You can confirm the presence of CaCO3 by doing a 5% distilled white vinegar test. A positive test is the visible emission of bubbles (CO2

) upon applying the vinegar to the product. Make sure you do the test after you have made sure your sample is completely dry and you have already quantified your CO2 uptake, as you will release some of your captured CO2 during this test.

Storage

The unit is fine to sit closed for long periods of time. If you leave the water inside, the water will very slowly evaporate. For longer-term storage, empty the water, dry, and store the equipment together. As for storage of the product, partially-reacted Ca(OH)2 stored in thin layers will fully react over time, and it would be educational to check the weight increase over time.

Disposal/Reuse

Calcium carbonate is a safe material that surrounds any unreacted Ca(OH)2

. Over time, even the
unreacted Ca(OH)2 will get carbonated. Disposal should be the same for typical soil materials. Calcium carbonate also has many uses: https://sciencestruck.com/uses-of-calcium-carbonate. Note that just because this link includes many medical applications of CaCO3 does not mean you should ingest it - this rule applies for any product you might produce. However, It is fine to use it in the garden as a treat for tomatoes!

16

More Pictures

Filter paper removed to show unit ready for loading

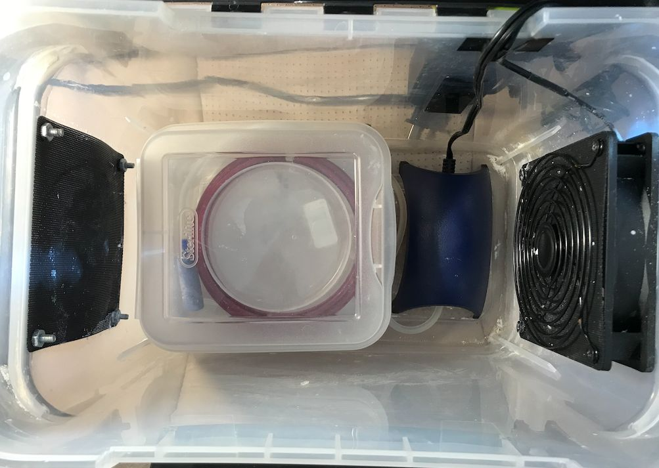
[picture p58: figure]

Filter paper has been removed and placed on top of the humidifier box to allow the fan to dry it

17

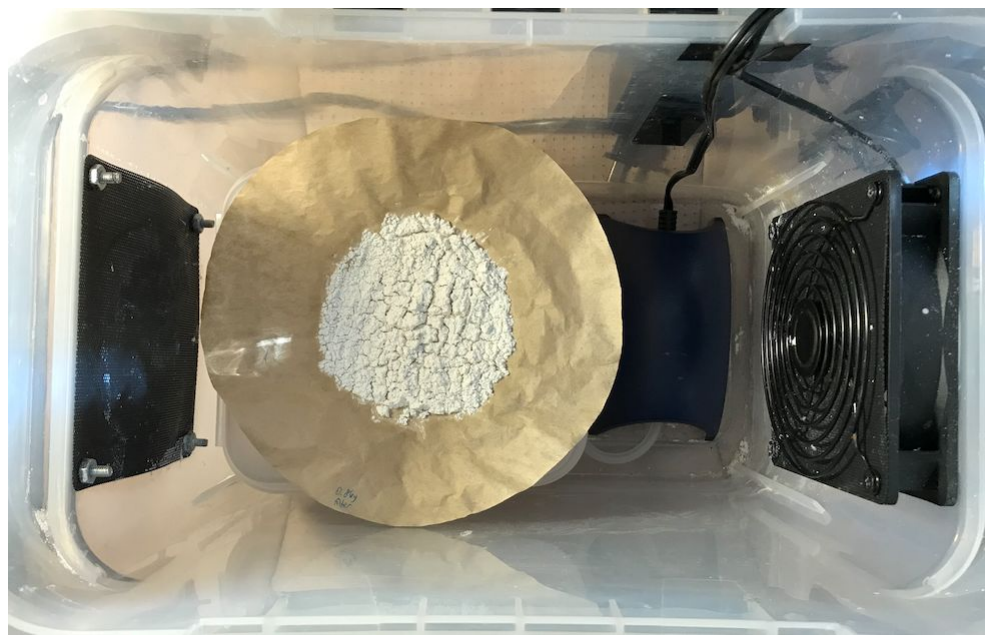
[picture p59: figure]

It all fits! This unit can be easily carried around.

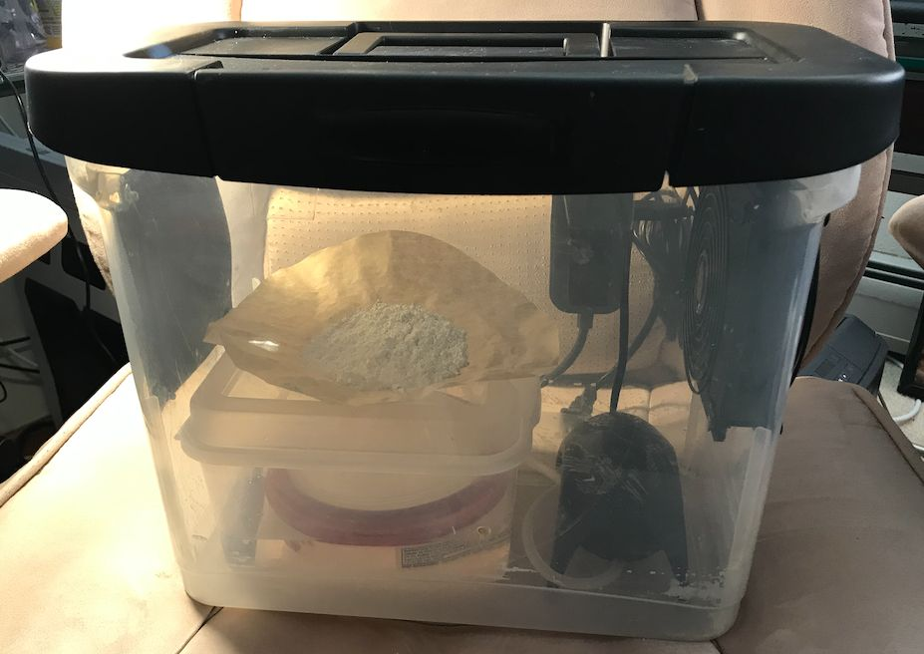
[picture p60: figure]

18
