openair-collective/openair-cyan/docs/assets/images/assemblyinst/box_fan_side.png

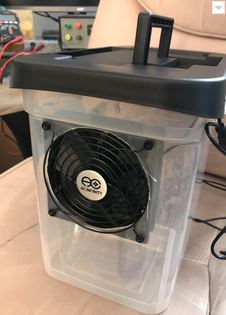
docs/assets/images/assemblyinst/box_fan_side.png
