openair-collective/openair-cyan/docs/assets/images/assemblyinst/computer_fan_actual.png

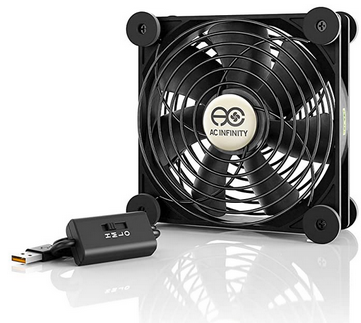
docs/assets/images/assemblyinst/computer_fan_actual.png
