openair-collective/openair-cyan/docs/assets/images/assemblyinst/fan_back.png

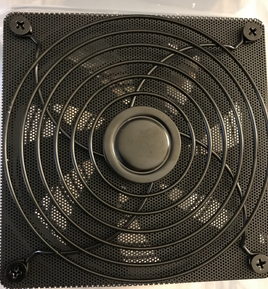
docs/assets/images/assemblyinst/fan_back.png
