openair-collective/openair-cyan/docs/assets/images/assemblyinst/fan_front.png

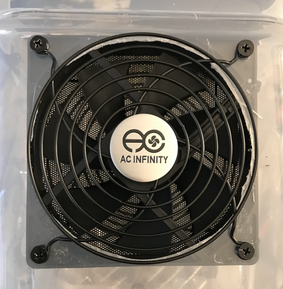
docs/assets/images/assemblyinst/fan_front.png
