openair-collective/openair-cyan/docs/assets/images/assemblyinst/loading_reaction_chamber.png

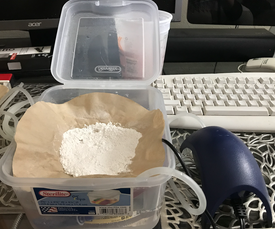
docs/assets/images/assemblyinst/loading_reaction_chamber.png
