openair-collective/openair-cyan/docs/assets/images/assemblyinst/tracing_fan_grille.png

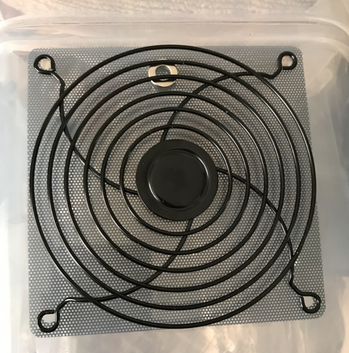
docs/assets/images/assemblyinst/tracing_fan_grille.png
