openair-collective/openair-cyan/docs/Reference_Docs/data/Cyan - CO2 Capture Measurements.xlsx

Sheet: Summary
Cyan CO2 Capture Experiments
average mmol CO2/g Ca(OH)2 |  | 2.64
Early Experiments
Experiment | mmol CO2/g Ca(OH)2 |  | Setup
Series 1 (old)
Jan7-21 | too much product loss |  | Box, water pump, fan, 24 hours
Jan10-21a | too much product loss |  | Box, water pump, fan, 24 hours
Jan10-21b | too much product loss |  | Completely wetted input, air pump and cup, 6.5 hours bubbling
Series 2 (new)
Jan11-21b | too much product loss |  | Completely wetted input, air pump and cup, 22 min bubbling
Jan11-21a | 0.63 |  | Completely wetted input, air pump and cup, 0 min bubbling
Jan12-21a | 0.69 |  | Completely wetted input, cup, sonicator, 15 min sonication
Jan12-21b | 1.96 |  | Dry input, humidification from sonicator, air pump, 1 hour
Jan13-21 | 2.46 |  | Dry input, humidification from sonicator, air pump, 2 hours
Weight Increase with Time
Experiment | Weight Increase (%) | Treatment time (hours) | Setup
Jan11-21a | 1.64% | 0.00 | Completely wetted input, air pump and cup, 0 min bubbling
Jan12-21a | 1.80% | 0.25 | Completely wetted input, cup, sonicator, 15 min sonication
Jan12-21b | 5.10% | 1.00 | Dry input, humidification from sonicator, air pump, 1 hour
Jan13-21 | 6.40% | 2 | Dry input, humidification from sonicator, air pump, 2 hours
1 day experiments
Experiment | mmol CO2/g Ca(OH)2 |  | Setup
Jan21-21b | 1.23 |  | standard except moved 1 inch above humid zone, fairly dry
Jan16-21b | 1.65 |  | aqueous solution of Ca(OH)2 while sonicated
Jan31-31 | 1.69 |  | standard except thin layer of Ca(OH)2, fairly dry, short dry time (1 hour)
Jan16-21a | 1.92 |  | wetted, collapsed pores in Ca(OH)2 powder
Jan30-31 | 2.77 |  | standard except thin layer of Ca(OH)2; later found wetted, so collapsed pores
Jan18-21 | 2.92 |  | standard except thin layer of Softsoap applied to lid
Jan21-21a | 3.39 |  | standard except thin layer of Ca(OH)2, 7 hour dry time
Jan20-21 | 3.62 |  | standard except thin layer of Ca(OH)2 and applied carbonic anhydrase VI mixed in
Jan16-21c | 4.81 |  | standard except used faster external fan instead of box fan; 3 hour dry time
Sucrose Addition
Jan26-21 | 1.89 |  | wetted, collapsed pores in Ca(OH)2+sucrose powder; 1 g sucrose
Jan29-21 | 2.62 |  | standard except addition of sucrose; later found wetted, so collapsed pores; 5 g sucrose
Jan24-21 | 2.85 |  | wetted, collapsed pores in Ca(OH)2+sucrose powder, sucrose created glassiness; 10 g sucrose
Jan27-21 | 3.00 |  | standard except addition of sucrose; later found wetted, so collapsed pores; 1 g sucrose

Sheet: January
Cyan CO2 Capture Measurements
 |  |  |  |  |  | Calculating CO2 capture: |  |  |  |  | If 100% yield, this is true: |  |  | Theoretical max CO2 capturable for 10 g Ca(OH)2
Used 10 g Ca(OH)2 input for each experiment unless otherwise stated | Ca(OH)2 | CO2 | CaCO3 | H2O |  | g CO2 captured = (mass_increase)/(MW_CaCO3 - MW_Ca(OH)2) * MW_CO2 |  |  |  |  |  |  | mass conservation: R1 + R2 = P1 + P2 |  | R2/R1 = 44/74
 | 74.09268 | 44.0095 | 100.0869 | 18.01528 | g/mol |  |  |  |  |  |  | P2 = 0.18 P1 |  |  | R2 = 44/74 * R1
Carbonation reaction for CO2 capture: | R1 | R2 | P1 | P2 |  |  |  |  |  |  |  | R1 + R2 = P1 + 0.18 P1 = 1.18 P1 |  |  | 5.94 | g CO2
Ca(OH)2 + CO2 -> CaCO3 + H2O |  |  |  |  |  |  |  |  |  |  |  | R2 = 1.18*P1 - R1 |  |  | 13.50 | mmol CO2/g Ca(OH)2
January 16 - 2021
start wetting | start wetting | stop sonic/start dry | stop dry | total wt | filter | cup | final wt | initial wt | wt increase | CO2 captured (g) | mmol CO2/g Ca(OH)2
 | 19:15:00 | 19:30:00 | 10:30:00 | 11.38 | 0.88 | 0 | 10.5 | 10 | 5% | 0.85 | 1.92
start sonication | start sonication | stop sonic/start dry | stop dry | total wt | filter | cup | final wt | initial wt | wt increase | CO2 captured (g) | mmol CO2/g Ca(OH)2
 | 20:08:00 | 21:08:00 | 10:30:00 | 13.27 | 0.84 | 2 | 10.43 | 10 | 4.3% | 0.73 | 1.65 | some product loss observed
start exposure of powder to humid air, enclosed container, air pump with air stone, dried using faster external fan instead of box fan | start treatment | stop humid/start dry | stop dry | total wt | filter | cup | final wt | initial wt | wt increase | CO2 captured (g) | mmol CO2/g Ca(OH)2
 | 21:19:00 | 10:19:00 | 1:22:00 | 12.11 | 0.86 | 0 | 11.25 | 10 | 12.50% | 2.12 | 4.81 | probably not dry enough?
 |  |  | 1:56:00 | 12.12
 |  |  | 3 hours dry time; seems too short
January 18-19 - 2021
start exposure of powder to humid air, enclosed container, air pump with air stone, thin spread of Softsoap on HDX lid before coffee filter applied; some went into the water. Goal was to test surfactant contribution; layer was a bit thick though | start treatment | stop humid/start dry | stop dry | total wt | filter | cup | final wt | initial wt | wt increase | CO2 captured (g) | mmol CO2/g Ca(OH)2
 | 23:50:00 | 12:50:00 | 14:46:00 | 15.74 | 0.86 | 0 | 10.76 | 10 | 7.60% | 1.29 | 2.92
 |  |  | 16:00:00 | 13.3
 |  |  | 16:18:00 | 12.71
 |  |  | 19:06:00 | 11.62
January 20 - 2021
applied small quantity of carbonic anhydrase VI (I read that H2CO3 formation was a limiting step), made thin layer between two filters, started exposure to humid air | start treatment | stop humid/start dry | stop dry | total wt | filter | cup | final wt | initial wt | wt increase | CO2 captured (g) | CO2 captured after 10 days | mmol CO2/g Ca(OH)2
 | 20:35:00 | 10:37:00 | 15:34:00 | 16.57 | 1.73 | 0 | 10.94 | 10 | 9.40% | 1.59 | 1.78 | 3.62
 |  |  | 20:37:00 | 12.67
 |  |  | 10 days later | 12.78 | evidence of more carbonation
January 21 - 2021
a) Thin layer, in high humidity from air stone | start treatment | stop humid/start dry | stop dry | total wt | filter | cup | final wt | initial wt | wt increase | CO2 captured (g) | CO2 captured after 9 days | mmol CO2/g Ca(OH)2
 | 23:30:00 | 10:42:00 | 17:40:00 | 11.73 | 0.85 | 0 | 10.88 | 10 | 8.80% | 1.49 | 1.63 | 3.39
 |  |  | 9 days later | 11.81 | evidence of more carbonation
b) Thin layer, top (removed from the high humidity by 1 inch, not wetted from bottom) | start treatment | stop humid/start dry | stop dry | total wt | filter | cup | final wt | initial wt | wt increase | CO2 captured (g) | CO2 captured after 9 days | mmol CO2/g Ca(OH)2
 | 23:30:00 | 10:42:00 | 17:40:00 | 11.17 | 0.85 | 0 | 10.32 | 10 | 3.20% | 0.54 | 1.79 | 1.23
 |  |  | 9 days later | 11.91 | evidence of more carbonation
Sucrose Addition Experiments
January 24 - 2021
Trying sucrose to increase calcium solubility; sprayed water to soak until wet, then allowed to dry | https://www.researchgate.net/publication/265850297_Surfactant-assisted_synthesis_of_pure_calcium_carbonate_nanoparticles_from_Sri_Lankan_dolomite
10 g Ca(OH)2 | 10 | g
10 g sucrose (complexes with Ca(OH)2) | 10.03 | g
filter | 0.86 | g
total initial wt | 29.15 | g
 | start humidification | stop humid/start dry | stop dry | total final wt | filter | final reactant wt | initial wt | wt increase | CO2 captured (g) | mmol CO2/g Ca(OH)2
 | 0:13:00 | 0:13:00 | 20:17:00 | 23.37 | 0.86 | 22.51 | 20.03 | 3.694458313% | 1.25 | 2.85
 | elapsed times: | 0 hours | 20 hours
January 26 - 2021 |  |  | 2 days later | 21.63 |  | 20.77
vinegar test was done on previous experiment's product - could hear bubbling, so now I am repeating that experiment with a lower amount of sucrose so the product doesn't glass over with sucrose.
10 g Ca(OH)2 | 10 | g
1 g sucrose | 1.01 | g
filter | 0.86 | g
total initial wt | 11.87 | g
sprayed with water until wet, then immediately set out to dry inside box, fan on high | start humidification | stop humid/start dry | stop dry | total final wt | filter | final reactant wt | initial wt | wt increase | CO2 captured (g) | mmol CO2/g Ca(OH)2
 | 21:15:00 | 21:15:00 | 11:27:00 | 12.36 | 0.86 | 11.5 | 11.01 | 4.450499546% | 0.83 | 1.89
January 27 - 2021 | elapsed times: | 0 hours | 14 hours
Put inside reaction chamber as dry mixed powder, no spraying with water, fan on high whole time
10 g Ca(OH)2 | 10 | g
1 g sucrose | 1.01 | g
filter | 0.86 | g
total initial wt | 11.87 | g
 | start treatment | start dry | stop dry | total final wt | filter | final reactant wt | initial wt | wt increase | CO2 captured (g) | mmol CO2/g Ca(OH)2
 | 13:05:00 | 22:05:00 | 9:28:00 | 12.98 | 0.86 | 12.12 | 11.01 | 7.084468665% | 1.32 | 3.00
 | elapsed times: | 9 hours | 11 hours
January 29 - 2021 |  |  | 1 day later | 12.65 |  | 11.79
Put inside reaction chamber as dry mixed powder, no spraying with water, fan on high whole time
10 g Ca(OH)2 | 10 | g
5 g sucrose | 5 | g
filter | 0.86 | g
total initial wt | 15.86 | g
when taken out to dry, was soaking in water and hard to separate paper from plastic lid in places | start treatment | start dry | stop dry | total final wt | filter | final reactant wt | initial wt | wt increase | CO2 captured (g) | mmol CO2/g Ca(OH)2
 | 16:21:00 | 9:00:00 | 16:14:00 | 19.3 | 0.86 | 18.44 | 15 | 4.533333333% | 1.15 | 2.62
 | elapsed times: | 16.5 hours | 16:45:00 | 18.73 |  | 17.87
 |  |  | 18:42:00 | 17.4 |  | 16.54
 |  |  | 19:06:00 | 17.24 |  | 16.38
 |  |  | 20:00:00 | 17.18 |  | 16.32
 |  |  | 20:14:00 | 17.16 |  | 16.3
 |  |  | 22:22:00 | 17.03 |  | 16.17
 |  |  | 9:57:00 | 16.54 |  | 15.68
January 30 - 2021 - still in progress, waiting to dry completely |  |  | 25 hours
Just 5 g Ca(OH)2 in thin layer, humidified, no sucrose
Ca(OH)2 | 5 | g
filter | 0.85 | g
total initial wt | 5.85 | g
when taken out to dry, soaking in water | start treatment | start dry | stop dry | total final wt | filter | final reactant wt | initial wt | wt increase | CO2 captured (g) | mmol CO2/g Ca(OH)2
 | 22:19:00 | 10:13:00 | 15:14:00 | 6.26 | 0.85 | 5.41 | 5 | 7.2% | 0.61 | 2.77
 | elapsed times: | 12 hours | 15:40:00 | 6.21 |  | 5.36
 |  |  | 16:07:00 | 6.21
 |  |  | 18:15:00 | 6.24
January 31 - 2021 |  |  | 20:50:00 | 6.25
Just 5 g Ca(OH)2 in thin layer, humidified, water level lower in reaction chamber than yesterday
Ca(OH)2 | 5 | g
filter | 0.86 | g
total initial wt | 5.86 | g
not soaking in water, able to dry quickly | start treatment | start dry | stop dry | total final wt | filter | final reactant wt | initial wt | wt increase | CO2 captured (g) | mmol CO2/g Ca(OH)2
 | 10:13:00 | 20:34:00 | 21:28:00 | 6.26 | 0.86 | 5.4 | 5 | 4.4% | 0.37 | 1.69
 |  |  | 21:48:00 | 6.08 |  | 5.22

Sheet: Jan13-21
Cyan CO2 Capture Measurement - 2 hour humidification
Dahl Winters, 1/13/2021
Conditions: indoors in small room, room temperature (68 F, 20 C), cloud of 5 micron water droplets produced via sonicator and allowed to contact dry Ca(OH)2 for 2 hours
No direct sonication of Ca(OH)2. Humidification done in enclosed space (file box with ports sealed with plastic wrap). Air pump with air stone also used to introduce new air into the sonicated water.
Added exactly 10 g input Ca(OH)2.
 | g | g/mol | mol |  | Carbonation reaction for CO2 capture:
Input, Bonide brand Hydrated Lime (> 90% Ca(OH)2) | 10 | 74.09268 | 0.1349660992 |  | Ca(OH)2 + CO2 -> CaCO3 + H2O
Expected CaCO3, if complete CO2 absorption were possible | 13.51 | 100.0869 | 0.1349660992
Expected H2O produced from Ca(OH)2 | 2.43 | 18.01528 | 0.1349660992
Expected CO2 captured (CaCO3 + H2O - Ca(OH)2) | 5.94
Expected mass of right side of reaction | 15.94
Expected mass of left side of reaction | 15.94
Actual CaCO3 measurement | g | g/mol | mol | other
coffee filter | 0.86
dry coffee filter + product | 11.5
dry product only | 10.64 | 100.0869 | 0.1063076187
Increase in weight over time t | 0.64
Time t (hours) |  |  |  | 0.25
Rate of weight increase (g/hour) |  |  |  | 2.56
Percent weight increase |  |  |  | 6.40%
max CO2 capturable (calculated from dry product assuming it is 100% CaCO3) | 4.68 | 44.0095 | 0.1063076187
actual CO2 captured | 1.08
g CO2 captured = (mass_increase)/(MW_CaCO3 - MW_Ca(OH)2) * MW_CO2
 | 0.11 | g CO2/g sorbent
 | 0.002462085802 | mol CO2/g sorbent
For comparison with Cyan Supporting System Calculations spreadsheet | 2.462085802 | mmol CO2/g sorbent
kg Ca(OH)2 sorbent needed to capture 1 kg/day CO2 | 9.229 | kg Ca(OH)2
kg Dowex sorbent needed to capture 1 kg/day CO2 | 29.000 | kg Dowex
(for comparison, from DACC HACC Design Considerations page)

Sheet: Jan12-21b
Cyan CO2 Capture Measurement - 1 hour humidification
Dahl Winters, 1/12/2021
Conditions: indoors in small room, room temperature (68 F, 20 C), cloud of 5 micron water droplets produced via sonicator and allowed to contact dry Ca(OH)2 for 1 hour
No direct sonication of Ca(OH)2. Humidification done in enclosed space (file box with ports sealed with plastic wrap). Air pump with air stone also used to introduce new air into the sonicated water.
Added exactly 10 g input Ca(OH)2.
 | g | g/mol | mol |  | Carbonation reaction for CO2 capture:
Input, Bonide brand Hydrated Lime (> 90% Ca(OH)2) | 10 | 74.09268 | 0.1349660992 |  | Ca(OH)2 + CO2 -> CaCO3 + H2O
Expected CaCO3, if complete CO2 absorption were possible | 13.51 | 100.0869 | 0.1349660992
Expected H2O produced from Ca(OH)2 | 2.43 | 18.01528 | 0.1349660992
Expected CO2 captured (CaCO3 + H2O - Ca(OH)2) | 5.94
Expected mass of right side of reaction | 15.94
Expected mass of left side of reaction | 15.94
Actual CaCO3 measurement | g | g/mol | mol | other
coffee filter | 0.86
dry coffee filter + product | 11.37
dry product only | 10.51 | 100.0869 | 0.1050087474
Increase in weight over time t | 0.51
Time t (hours) |  |  |  | 0.25
Rate of weight increase (g/hour) |  |  |  | 2.04
Percent weight increase |  |  |  | 5.10%
max CO2 capturable (calculated from dry product assuming it is 100% CaCO3) | 4.62 | 44.0095 | 0.1050087474
actual CO2 captured | 0.86
g CO2 captured = (mass_increase)/(MW_CaCO3 - MW_Ca(OH)2) * MW_CO2
 | 0.09 | g CO2/g sorbent
 | 0.001961974624 | mol CO2/g sorbent
For comparison with Cyan Supporting System Calculations spreadsheet | 1.961974624 | mmol CO2/g sorbent
kg Ca(OH)2 sorbent needed to capture 1 kg/day CO2 | 11.581 | kg Ca(OH)2
kg Dowex sorbent needed to capture 1 kg/day CO2 | 29.000 | kg Dowex
(for comparison, from DACC HACC Design Considerations page)

Sheet: Jan12-21a
Cyan CO2 Capture Measurement - 15 minute sonication
Dahl Winters, 1/12/2021
Conditions: indoors in small room, room temperature (68 F, 20 C), water added, sonicated for 15 minutes using 24 watt sonicator, then started filtering
Sonication made the water warm to the touch but the temperature was not measured. Goal was to try to break down passivating layer of CaCO3 around Ca(OH)2 particles.
Added exactly 10 g input Ca(OH)2.
 | g | g/mol | mol |  | Carbonation reaction for CO2 capture:
Input, Bonide brand Hydrated Lime (> 90% Ca(OH)2) | 10 | 74.09268 | 0.1349660992 |  | Ca(OH)2 + CO2 -> CaCO3 + H2O
Expected CaCO3, if complete CO2 absorption were possible | 13.51 | 100.0869 | 0.1349660992
Expected H2O produced from Ca(OH)2 | 2.43 | 18.01528 | 0.1349660992
Expected CO2 captured (CaCO3 + H2O - Ca(OH)2) | 5.94
Expected mass of right side of reaction | 15.94
Expected mass of left side of reaction | 15.94
Actual CaCO3 measurement | g | g/mol | mol | other
coffee filter | 0.86
dry coffee filter + product | 11.04
dry product only | 10.18 | 100.0869 | 0.1017116126
Increase in weight over time t | 0.18
Time t (hours) |  |  |  | 0.25
Rate of weight increase (g/hour) |  |  |  | 0.72
Percent weight increase |  |  |  | 1.80%
max CO2 capturable (calculated from dry product assuming it is 100% CaCO3) | 4.48 | 44.0095 | 0.1017116126
actual CO2 captured | 0.30
g CO2 captured = (mass_increase)/(MW_CaCO3 - MW_Ca(OH)2) * MW_CO2
 | 0.03 | g CO2/g sorbent
 | 0.0006924616319 | mol CO2/g sorbent
For comparison with Cyan Supporting System Calculations spreadsheet | 0.6924616319 | mmol CO2/g sorbent
kg Ca(OH)2 sorbent needed to capture 1 kg/day CO2 | 32.814 | kg Ca(OH)2
kg Dowex sorbent needed to capture 1 kg/day CO2 | 29.000 | kg Dowex
(for comparison, from DACC HACC Design Considerations page)
Notes:
Filtering/drying: 6 hours, during which time the Ca(OH)2 could have picked up more CO2, especially since a fan was used for the first 3 hours of drying.

Sheet: Jan11-21b
Cyan CO2 Capture Measurement - 22 minute bubbling time
Dahl Winters, 1/11/2021
Conditions: indoors in small room, room temperature (68-72 F), water added, bubbled for 22 minutes using 1.5 watt air pump with air stone, then started filtering
 | g | g/mol | mol | Carbonation reaction for CO2 capture:
Input, Bonide brand Hydrated Lime (> 90% Ca(OH)2) | 28.86 | 74.09268 | 0.3895121623 | Ca(OH)2 + CO2 -> CaCO3 + H2O
Expected CaCO3, if complete CO2 absorption were possible | 38.99 | 100.0869 | 0.3895121623
Expected H2O produced from Ca(OH)2 | 7.02 | 18.01528 | 0.3895121623
Expected CO2 captured (CaCO3 + H2O - Ca(OH)2) | 17.14
Expected mass of right side of reaction | 46.00
Expected mass of left side of reaction | 46.00
Actual CaCO3 measurement | g | g/mol | mol
coffee filter | 0.83
dry coffee filter + product | 29.06
dry product only | 28.23 | 100.0869 | 0.2820548943 | a film of large surface area was left on the sides of the container; film not weighed
Increase in weight over time t | -0.63
Notes:
A positive vinegar test was observed after final weighing of the product, same as in previous experiments.
Filtering/drying: 12 hours, during which time the Ca(OH)2 could have picked up more CO2, especially since a fan was used for drying.

Sheet: Jan11-21a
Cyan CO2 Capture Measurement - control, no bubbling
Dahl Winters, 1/11/2021
Conditions: indoors in small room, room temperature (68-72 F), water added, then 5 minutes later started filtering
This is a control test - if weight increase is observed and there is a negative visual vinegar test for CO2, then weight increase cannot indicate the presence of CO2.
If weight increase is observed and there is a positive vinegar test for CO2, then that means the reaction is happening more quickly than anticipated.
 | g | g/mol | mol | Carbonation reaction for CO2 capture:
Input, Bonide brand Hydrated Lime (> 90% Ca(OH)2) | 23.84 | 74.09268 | 0.3217591805 | Ca(OH)2 + CO2 -> CaCO3 + H2O
Expected CaCO3, if complete CO2 absorption were possible | 32.20 | 100.0869 | 0.3217591805
Expected H2O produced from Ca(OH)2 | 5.80 | 18.01528 | 0.3217591805
Expected CO2 captured (CaCO3 + H2O - Ca(OH)2) | 14.16 | 44.0095 | 0.3217591805
Expected mass of right side of reaction | 38.00
Expected mass of left side of reaction | 38.00
Actual CaCO3 measurement | g | g/mol | mol
coffee filter | 0.83
dry coffee filter + product | 25.06
dry product only | 24.23 | 100.0869 | 0.2420896241
Increase in weight over time t | 0.39
max CO2 capturable (calculated from dry product assuming it is 100% CaCO3) | 10.65 | 44.0095 | 0.2420896241
actual CO2 captured | 0.66
g CO2 captured = (mass_increase)/(MW_CaCO3 - MW_Ca(OH)2) * MW_CO2
 | 0.03 | g CO2/g sorbent
 | 0.0006293345368 | mol CO2/g sorbent
For comparison with Cyan Supporting System Calculations spreadsheet | 0.6293345368 | mmol CO2/g sorbent
kg Ca(OH)2 sorbent needed to capture 1 kg/day CO2 | 36.105 | kg Ca(OH)2
Notes:
A positive vinegar test was observed after final weighing of the product, same as in previous experiments.
Filtering/drying: 12 hours, during which time the Ca(OH)2 could have picked up more CO2, especially since a fan was used for drying.

Sheet: Jan10-21b
3rd Cyan CO2 Capture Measurement
Dahl Winters, 1/10/2021
Conditions: indoors in small room, room temperature (68-72 F) over a 6.5 hour period - no fan, air bubbled with Tetra Whisper 10 aquarium air pump (1.5 watt) and air stone
Started filtering right after
A good bit of clay-like bottom solids that were impurities, maybe 1/6 of the total quantity. Needed 12 hours dry time.
 | g | g/mol | mol | Carbonation reaction for CO2 capture:
Input, Bonide brand Hydrated Lime (> 90% Ca(OH)2) | 25.33 | 74.09268 | 0.3418691293 | Ca(OH)2 + CO2 -> CaCO3 + H2O
Expected CaCO3, if complete CO2 absorption were possible | 34.22 | 100.0869 | 0.3418691293
Expected H2O produced from Ca(OH)2 | 6.16 | 18.01528 | 0.3418691293
Expected CO2 captured (CaCO3 + H2O - Ca(OH)2) | 15.05 | 44.0095 | 0.3418691293
Expected mass of right side of reaction | 40.38
Expected mass of left side of reaction | 40.38
Actual CaCO3 measurement | g | g/mol | mol
coffee filter | 0.83
dry coffee filter + product | 23.09
dry product only | 22.26 | 100.0869 | 0.2224067286
Increase in weight over time t | -3.07

Sheet: Jan10-21a
2nd Cyan CO2 Capture Measurement
Dahl Winters, 1/10/2021
Conditions: indoors in small room, room temperature (68-72 F) over a 24 hour period
Changed out aquarium water pump for a smaller but more powerful USB pump, $9, first one stopped working due to previous heavy testing within 3 min of pouring in Ca(OH)2
4 hour delay with fan on low before water began circulating; then circulation for 20 hours with fan on high
After 24 hours, started filtering
Process took a while due to larger quantity of material and clay-like consistency of bottom solids that were impurities. Needed lots of dry time (1.5 days).
Used Bonide's Hydrated Lime because the SDS claimed > 90% calcium hydroxide (Ca(OH)2), but the bag itself indicated Ca(OH)2 and also MgOH, MgO, and CaO in smaller quantities.
 | g | g/mol | mol | Carbonation reaction for CO2 capture:
Input, Bonide brand Hydrated Lime (> 90% Ca(OH)2) | 90.92 | 74.09268 | 1.227111774 | Ca(OH)2 + CO2 -> CaCO3 + H2O
Expected CaCO3, if complete CO2 absorption were possible | 122.82 | 100.0869 | 1.227111774
Expected H2O produced from Ca(OH)2 | 22.11 | 18.01528 | 1.227111774
Expected CO2 captured (CaCO3 + H2O - Ca(OH)2) | 54.00 | 44.0095 | 1.227111774
Expected mass of right side of reaction | 144.92
Expected mass of left side of reaction | 144.92
Actual CaCO3 measurement | g | g/mol | mol
coffee filter | 0.83
dry coffee filter + product | 80.72
dry product only | 79.89 | 100.0869 | 0.7982063587
Increase in weight over time t | -11.03

Sheet: Jan7-21
Initial Cyan CO2 Capture Benchmark
Dahl Winters, 1/7/2021
Conditions: indoors in small room, room temperature (68-72 F) each day - fan on lowest of three speeds and off at night (aquarium pump still going)
5 day run time as above, 1 day sit time (no flow or fan) to get crystal (CaCO3) formation
Took 5 days because goal was stability testing vs. quantification of CO2 capture; didn't intend to quantify during this run. Possible for reaction to be done within a few hours.
Thus, next steps are:
- Will turn on fan to highest setting and leave on at night next; do reaction over a single 24 hour timeframe
- Will quantify with guaranteed >90% pure Ca(OH)2
 | g | g/mol | mol
Input, solid CaCl2 (Prestone Driveway Heat, CaCl2 quantity varies) | 22.2 | 110.984 | 0.200028833 | Reaction to generate Ca(OH)2:
Input, solid NaOH, very pure (lye for drain opening) | 7.99 | 39.99711 | 0.199764433 | CaCl2 + 2NaOH -> Ca(OH)2 + 2NaCl
Note: I actually added the same mol NaOH as CaCl2 instead of double the mol NaOH, so I actually started carbon capture with half as much Ca(OH)2 as I wanted.
Hence E18 below has been divided by 2 to compensate.
 | g | g/mol | mol
Expected Ca(OH)2 produced (input to carbonatation reaction) | 7.40 | 74.09268 | 0.09988221649 | Carbonation reaction for CO2 capture:
Expected CaCO3, if complete CO2 absorption were possible | 10.00 | 100.0869 | 0.09988221649 | Ca(OH)2 + CO2 -> CaCO3 + H2O
100% absorption is unlikely given the limited solubility of Ca(OH)2 in water, 1.7 g/L at 20 C - the gas/solid interface is important but unknown how it should perform in aqueous solution
Actual CaCO3 measurement | g | g/mol | mol
coffee filter | 0.83
dry coffee filter + product | 4.86
dry product only | 4.03 | 100.0869 | 0.04026500971
Increase in weight over time t | -3.37
