openair-collective/openair-cyan/(threads)

Thread 5 (2021-12-05):

alternatives for Hydrated Lime

DanTaranis, 2021-12-05:

DanTaranis, 2021-12-05:
Hi - I want to do a DIY session with the people in my company - we are in Israel - and apparently Hydrated Lime is super rare here because the ground is already somewhat basic.

Are there any simple cheap alternatives?

DanTaranis, 2021-12-06:
after some research it looks like an alternative is magnesium oxide pills (crushed) - if I understand correctly - magnesium oxide turns into magnesium hydroxide when in water.
it's expensive but much more available here - the only thing I'm concerned about is the purity - but should be good enough for the session to get people excited.

DanTaranis, 2021-12-06:
from seeing your youtube videos it sounds like I can also just buy cement - mix it with water and then break it up and use that?

dahlwinters, 2021-12-06:
Hi @DanTaranis, great to meet you! While calcium (or magnesium) oxide does take up CO2 to form calcium carbonate, it is produced by calcining limestone which gives off a large amount of CO2. Calcium hydroxide (hydrated lime, which is hydrated calcium oxide) at least has the option of being made without calcination (presently in small amounts). If there are saltwater aquaria nearby, they will carry a very pure calcium hydroxide as kalkwasser.

Magnesium hydroxide powder is available online - I wouldn't get pills since they contain binders and other ingredients that might also react with CO2 or the water used.

If you add water to cement, it will definitely harden and form calcium hydroxide but the amount of calcium hydroxide you'll obtain is relatively small (20-25%) - the rest is mostly a calcium-silicate-hydrate gel. Crushing recycled concrete aggregate and carbonating it in the presence of humidity would help to carbonate that small fraction of calcium hydroxide and that would indeed take up CO2, but you will likely get other minerals forming, making it impossible to determine the carbon captured using the weight difference.

danFromTelAviv, 2021-12-06:
thank you for your super thorough answer.
as this is mostly for educational reasons 20-25% is good enough for me but ill make sure to let everyone know that in reality this exact material is not "it".

thanks!

ZanzyTHEbar, 2022-05-02:
Closing issue, and added tags for future people to be able to view this topic :)

Closed 2022-05-02.

Thread 7 (2024-04-11):

Arduino?

dgutson, 2024-04-11:
Hi,

  Could Cyan be improved with some sensor-actuator system (like Arduino), for example to control the speed of the fan, or heating the inside part of the box?
I know epiphyte uses arduino but it seems much more expensive and probably less mature. I'm asking this for the creation of a school course for kids.

KCollins, 2024-04-11:
Hi Daniel,
Cyan's not currently under development, and as far as I know there's no version of it that has used Arduino in the past. However, it probably is the best starting point for a school course, and any efforts to develop it further for that purpose are certainly more than welcome. Best of luck!

dgutson, 2024-04-11:
@KCollins I tried to look for your email before to ask this there, couldn't find it.
Any chance somebody could help me to create such a course? Ideas? I don't need help with the firmware itself, but with ideas about what role it could take? Please?

KCollins, 2024-04-11:
Come join the OpenAir Discord! https://openaircollective.com/join/
There will be likeminded folks there. Sounds like a worthy effort!

Closed 2024-04-11.
