openair-collective/openair-cyan/(commit log)

2021-02-09 Adding initial Cyan Assembly Instructions
2021-02-09 Adding supporting spreadsheets
    [Cyan - CO2 Capture Measurements.xlsx, Cyan - Supporting System Calculations.xlsx]
2021-02-15 Uploading assembly instruction photos for wiki
2021-02-16 Adding parts lists
    [Parts_List_Advanced.csv, Parts_List_Minimal.csv]
2021-02-16 Formatting advanced parts list
    [Parts_List_Advanced.csv, Parts_List_Basic.csv]
2021-02-16 Formatting the basic parts list
    [Parts_List_Basic.csv]
2021-02-16 Adding optional supplies
    [Optional_Supplies.csv, Parts_List_Complete.csv, Parts_List_Minimal.csv]
2022-05-02 update - full refactor
    [Cyan - CO2 Capture Measurements.xlsx, Cyan - Supporting System Calculations.xlsx, Optional_Supplies.csv, Parts_List_Complete.csv, Parts_List_Minimal.csv]
2022-05-02 refactor documentation
    [Cyan - CO2 Capture Measurements.xlsx, Cyan - Supporting System Calculations.xlsx, Optional_Supplies.csv, Parts_List_Complete.csv, Parts_List_Minimal.csv]
2022-05-02 update all possible relevant links
    [Cyan - Supporting System Calculations.csv]
2022-05-02 total refactor
    Total refactor of Github Repo-
    Implemented proper organization, relative links, and beginnings of Github Pages
    [Cyan - CO2 Capture Measurements.xlsx, Cyan - Supporting System Calculations.csv, Cyan - Supporting System Calculations.xlsx, Optional_Supplies.csv, Parts_List_Complete.csv, Parts_List_Minimal.csv]
